skurwa/smart-cart/Final Deliverables/Poster/images/smartCart.JPG

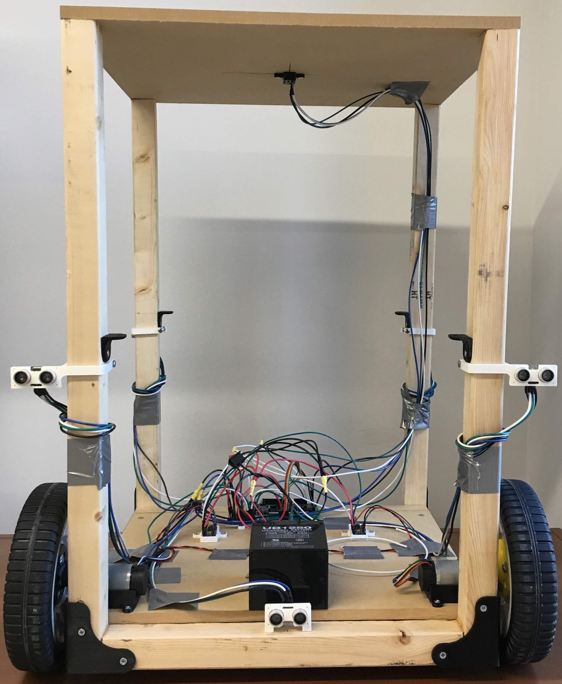
Final Deliverables/Poster/images/smartCart.JPG
