skurwa/smart-cart/README.md

# smart-cart
Design, analysis, schematics, code, and documentation of project to build an autonomous shopping cart.
