skurwa/smart-cart/Proposal/Smart Cart Proposal.docx

Smart Cart Proposal

Siddharth Kurwa

Mechanical Engineering

University of Texas at Austin

16 August 2018

Revision 2

# Background

In the 1930s, a supermarket owner named Sylvan Goldman recognized a critical problem to his business: shoppers only purchased as much as they could carry. To overcome this, Goldman designed and implemented a cart to enable people to carry more products through his stores. While consumers were initially reluctant to use the cart in Goldman’s Humpty Dumpty supermarket chain, the shopping cart now pervades across most stores and is intrinsically tied to our modern shopping experience (Dunne, 2014).

Between 1937 and today, there have been modest updates to the shopping cart to optimize the design and reflect improvements in materials and manufacturing techniques. For example, modern cart cages are largely made of plastic rather than the spot-welded steel, rear walls are hinged to enable efficient stacking and storage, and product storage capacity has increased to 15,000 cubic inches to ensure that volume availability does not limit quantity of purchases (Crockett, 2016). To date, these improvements have been largely focused on mechanical design modifications, unreflective of current technology trends.

Today’s growing sensor solutions, rising storage and data capacities, and increased accessibility of powerful controllers have propelled growth in “intelligent” and connected devices like smart home systems, autonomous vehicles, and health-monitoring wearables (Ahmed, n.d.). These technologies can be applied to the shopping cart to further refine the in-store consumer journey.

To that end, modern retailers are actively working on deploying these technologies to drive consumer retention and growth. For instance, FiveElements Robotics developed a robotic shopping cart called Dash in 2016 to follow users around a store, carry products, and handle the payment process. However, after partnering with Walmart and scheduling production for early 2017, the product has not yet demonstrated the reliability to justify implementation at scale (Ackerman, 2016). Part of the reason is that there are still open areas of research like indoor localization that need refinement before commercialization (Zafari et. al., 2018).

That said, there is tremendous opportunity in working on this technology. The smart cart is a progression of the shopping cart to further address consumer’s latent needs. Consumers should no longer fret about strolling their cart or scanning their groceries, liberating the shopping experience. Beyond the grocery store, the smart cart’s underlying technologies have the potential to affect human-robot interactions in several other environments including warehouses, homes, and hotels.

# Project Statement

I envision a fully fleshed-out smart cart to be a motorized vehicle that offers storage volume, navigates around store obstacles (obstacle avoidance and path planning), follows the user around the store (indoor localization and target tracking), seamlessly scans items placed into the cart, and provides a payment terminal on the cart itself.

For the scope of this course, I plan to build a system with primary emphasis on the design and prototyping of the motorized system, secondary emphasis on obstacle avoidance and navigation control, and tertiary emphasis on indoor localization and target tracking. At this stage, I do not plan to work on the item scanner and payment terminal tasks of the cart. Further, industrial design and aesthetic will not be a priority in this functional prototype.

I propose that the minimum deliverable at the end of this course is a mobile robot that can carry a specified payload and reasonably sense and avoid obstacles in its path. Further the robot should demonstrate design intent and robustness that will allow it to serve as a platform for subsequent research on tasks involving indoor localization, item scanning, and payment handling.

# Schedule

This section will address how the project is being time-budgeted and appropriately scheduled to meet the minimum deliverable by the end of the semester.

Figure 1, below, depicts a high-level Gantt chart that roughly outlines the order in which tasks will be completed. As shown below, several weeks have been allocated towards testing and tuning. I anticipate that there are several issues and considerations that I will uncover as I dive into this project. To manage effectively manage those before the deliverable date, I have allotted several weeks to hashing out the details of the project. Further, five weeks have been allotted for part selection to account for finding parts and lead times to actually procure them.

Figure 1: Gantt chart.

To break down the project into manageable chunks before the deliverable date, I have set several milestones that will ensure that the project is tracking to successful completion. Figure 2 describes these milestones and their intended completion dates.

Figure 2: Milestone chart.

To plan the low-level tasks that must be completed and the hours that I anticipate each task taking, I have assembled a list in Figure 3 with sporty estimates of time requirements. To account for probable aggressiveness in this timeline, I have multiplied my estimates by two to more conservatively estimate time requirements and provide buffer for surprise issues that may arise.

Figure 3: Low-level task list.

# Requirements and Budget

I anticipate requiring a dedicated space in order to store materials and the developing prototype over the course of the semester. Further, I also anticipate requiring funding of $500 which should provide ample margin based on my projected costs that will be explained below. At this point, I have not secured a space or funding – both of which I am actively pursuing.

Given the project is in a preliminary stage, there is no finalized Bill of Materials, but I have listed parts I am fairly certain that I will need in Figure 4 to project a cost ballpark. I anticipate fabricating all the parts using the resources in the Maker Studio or in the student machine shop. I do not plan to require external/expert shop time.

Figure 4: Preliminary Bill of Materials.

# Proposed Credit

The scope of this project will demand that I apply a skillset learned from several courses in my ME degree plan and beyond. From a mechanical standpoint, I expect to use Solidworks for CAD design which uses skills from ME 302, perform some static flexible load analysis which will use EM 319 Mechanics of Solids and ME 338 Machine Elements, and develop some gear reduction or power distribution method that draws from learning in ME 350R Robot Mechanism Design. Motor selection and electronic wiring will use skills from ME 340 Mechatronics and ME 340L. Sensor selection and motor control will involve skills from ME 344 Dynamic Systems and Controls and ME 144L. The obstacle avoidance and indoor localization tasks are largely out of the scope of coursework and will demand that I do some independent learning.

Because of the breadth of this project (design, analysis, prototyping, electronics, and software) and the depth in active research (obstacle avoidance and indoor localization), I believe that it warrants three credit hours as a ME 377K Projects in Mechanical Engineering course.

# Works Cited

Ackerman, E. (2016, June 28). Walmart and Five Elements Robotics Working on Robotic Shopping Cart.

Retrieved August 5, 2018, from https://spectrum.ieee.org/automaton/robotics/industrial-robots/walmart-and-five-elements-robotics-working-on-robotic-shopping-cart

Ahmed, S. (n.d.). The Six Forces Driving the Internet of Things. Retrieved August 5, 2018, from

https://www.pwc.com/gx/en/technology/pdf/six-forces-driving-iot.pdf

Crockett, Z. (2016, February 18). How a Basket on Wheels Revolutionized Grocery Shopping. Retrieved

August 5, 2018, from https://priceonomics.com/how-a-basket-on-wheels-revolutionized-grocery/

Dunne, C. (2014, August 12). Weird History: Inventor Hired Models To Make Shopping Carts Seem Cool.

Retrieved August 5, 2018, from https://www.fastcompany.com/3034248/weird-history-inventor-hired-models-to-make-shopping-carts-seem-cool

Zafari, F., Gkelias, A., & Leung, K. K. (2018). A Survey of Indoor Localization Systems Technologies (Rep.

No. 1709.01015). https://arxiv.org/pdf/1709.01015.pdf
