skurwa/smart-cart/Final Deliverables/Poster/Poster.pptx

Design and Prototype of an Autonomous Shopping Cart

Siddharth Kurwa
Faculty Advisor: Dr. Carolyn Seepersad

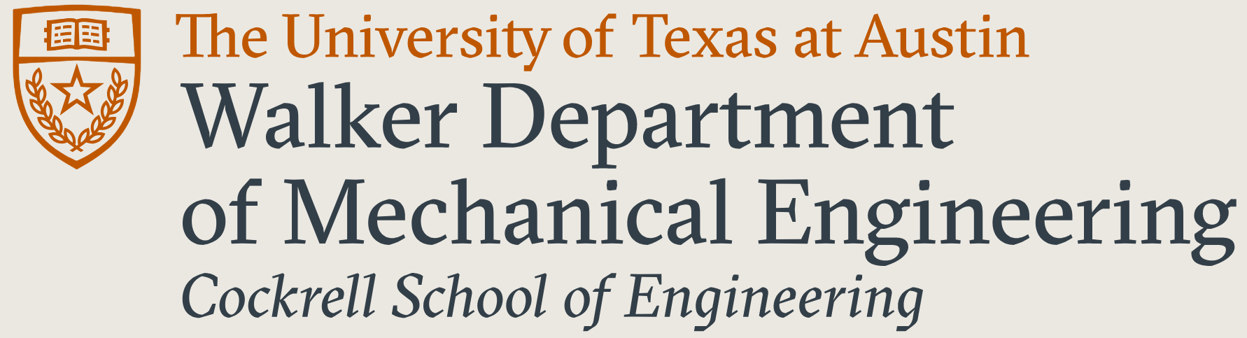
[picture p18: figure]

Background

Control System Design

Proximity Sensor Array

Setpoint Selector

+

PID

Encoder Feedback

Left Motor

Disturbance

+

+

+

PID

Encoder Feedback

Right Motor

Gyro Feedback

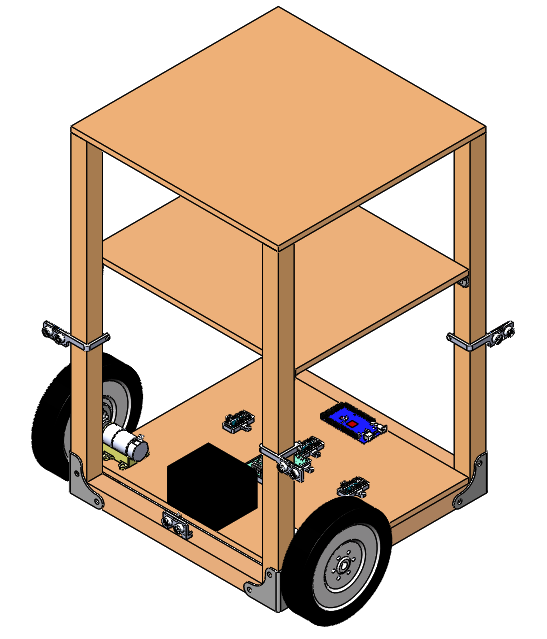
[picture p19: figure]

Distributed Computing Architecture over I²C Network

Proximity Sensor Measurement
Arduino Nano (slave)
4 Hz

Wheel Setpoints

Measured
Velocity

Right Encoder Processing and Motor Drive
Arduino Nano (slave)
10000 Hz

Measured
Velocity

Left Wheel Drive Signal

PID Loop
Arduino Mega (master)
40 Hz

Right Wheel Drive Signal

Left Encoder Processing and Motor Drive
Arduino Nano (slave)
10000 Hz

## Background

## Project Goals

## Mechanical Prototype

## Electrical Prototype

## Slide 6
