skurwa/smart-cart/Proposal/Smart Cart Proposal, rev3.pdf

### Smart Cart Proposal

Siddharth Kurwa
Mechanical Engineering
University of Texas at Austin 16 August 2018
Revision 3

Contents

Background
In the 1930s, a supermarket owner named Sylvan Goldman recognized a critical problem to his business: shoppers only purchased as much as they could carry. To overcome this, Goldman designed and implemented a cart to enable people to carry more products through his stores. While consumers were initially reluctant to use the cart in Goldman’s Humpty Dumpty supermarket chain, the shopping cart now pervades across most stores and is intrinsically tied to our modern shopping experience (Dunne, 2014).
Between 1937 and today, there have been modest updates to the shopping cart to optimize the design and reflect improvements in materials and manufacturing techniques. For example, modern cart cages are largely made of plastic rather than the spot-welded steel, rear walls are hinged to enable efficient stacking and storage, and product storage capacity has increased to 15,000 cubic inches to ensure that volume availability does not limit quantity of purchases (Crockett, 2016). To date, these improvements have been largely focused on mechanical design modifications, unreflective of current technology trends.
Today’s growing sensor solutions, rising storage and data capacities, and increased accessibility of powerful controllers have propelled growth in “intelligent” and connected devices like smart home systems, autonomous vehicles, and health-monitoring wearables (Ahmed, n.d.). These technologies can be applied to the shopping cart to further refine the in-store consumer journey.
To that end, modern retailers are actively working on deploying these technologies to drive consumer retention and growth. For instance, FiveElements Robotics developed a robotic shopping cart called Dash in 2016 to follow users around a store, carry products, and handle the payment process. However, after partnering with Walmart and scheduling production for early 2017, the product has not yet demonstrated the reliability to justify implementation at scale (Ackerman, 2016). Part of the reason is that there are still open areas of research like indoor localization that need refinement before commercialization (Zafari et. al., 2018).
That said, there is tremendous opportunity in working on this technology. The smart cart is a progression of the shopping cart to further address consumer’s latent needs. Consumers should no longer fret about strolling their cart or scanning their groceries, liberating the shopping experience. Beyond the grocery store, the smart cart’s underlying technologies have the potential to affect humanrobot interactions in several other environments including warehouses, homes, and hotels.

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

Schedule
This section will address how the project is being time-budgeted and appropriately scheduled to meet the minimum deliverable by the end of the semester.
Figure 1, below, depicts a high-level Gantt chart that roughly outlines the order in which tasks will be completed. Five weeks have been allotted for part selection to account for finding parts and lead times to actually procure them. As shown below, several weeks have been allocated towards testing and tuning. I anticipate that there are several issues and considerations that I will uncover as I dive into this project. To manage effectively manage those before the deliverable date, I have allotted several weeks to hashing out the details of the project. During this testing/tuning period, I also plan to prepare the poster and final report material required for course completion.

Figure 1: Gantt chart.

To break down the project into manageable chunks before the deliverable date, I have set several milestones that will ensure that the project is tracking to successful completion. Figure 2 describes these milestones and their intended completion dates.

Figure 2: Milestone chart.

To plan the low-level tasks that must be completed and the hours that I anticipate each task taking, I have assembled a list in Figure 3 with sporty estimates of time requirements. To account for probable aggressiveness in this timeline, I have multiplied my estimates by two to more conservatively estimate time requirements and provide buffer for surprise issues that may arise.

1 | 2 | 3 | 4 | 5 | 6 | 7 | 8 | 9 | 10 | 11 | 12 | 13 | 14 | 15
| Mechanical Design | | | | | | | | Week Phase
| Analysis
| Part Selection
| Prototyping
| Testing/Tuning
| Controls

End of:
Week 2 | Concept sketches and low-resolution prototypes developed.
Week 4 | CAD assembly completed. After this point, only tweaks and modifications should be necessary.
Week 6 | Electrical wiring/soldering/connectorizing should be completed.
Week 7 | Basic motor control functions complete and sensors are individually function-checked.
Week 14 | Obstacle avoidance should be logical and demonstrable.
Week 15 | Prototype demonstration/presentation.

Target Milestones

Figure 3: Low-level task list.

High Level | Tasks

Time Allotment
(hrs; no margin)

Time Allotment
(hrs; conservative)

Fall
| | | 2018? | Status
Design storage compartment | 4 | 8 | Y | Not started
Design wheel base | 7 | 14 | Y | Not started
Design sensor mounting | 4 | 8 | Y | Not started
Select/design power transmission
mechanics | 8 | 16 | Y | Not started
Design controls/power systems
enclosure | 8 | 16 | Y | Not started
Analyze payload capacity | 2 | 4 | Y | Not started
Analyze electrical load
requirements | 3 | 6 | Y | Not started
Analyze mechanical power/torque
distribution | 2 | 4 | Y | Not started
Select motors | 1 | 2 | Y | Not started
Select electrical hardware (power
supplies/circuit elements) | 5 | 10 | Y | Not started
Select sensors for obstacle
detection | 1 | 2 | Y | Not started
Select sensors for target tracking | 5 | 10 | | Not started
Build storage compartment
prototype | 5 | 10 | Y | Not started
Build wheel base prototype | 3 | 6 | Y | Not started
Build sensor mounting | 5 | 10 | Y | Not started
Build controls/power systems
enclosure | 5 | 10 | Y | Not started
System integration and assembly | 8 | 16 | Y | Not started
Configure circuit with necessary
elements | 2 | 4 | Y | Not started
Check functionality of each sensor
independently | 8 | 16 | Y | Not started
Program basic motor control | 2 | 4 | Y | Not started
Program obstacle avoidance
decision tree | 16 | 32 | Y | Not started
Program target tracking | 80 | 160 | | Not started
Program simultaneous target
tracking and obstacle avoidance
with interrupt-based state
machine architecture | 80 | 160 | | Not started
Time Required (All Tasks) | 264 | 528
Time Required (Fall 2018 Tasks) | 99 | 198 Controls Mechanical Design Analysis Part Selection Prototyping

Requirements and Budget
I anticipate needing a dedicated space in order to store materials and the developing prototype over the course of the semester.
Given the project is in a preliminary stage, there is no finalized Bill of Materials, but I have listed parts I am fairly certain that I will need in Figure 4 to project a cost ballpark. I anticipate fabricating all the parts using the resources in the Maker Studio or in the student machine shop. I do not plan to require external/expert shop time.

Figure 4: Preliminary Bill of Materials.

Dr. Seepersad has offered space in her lab and funding up to $250 (further funding can be discussed if necessary). Her support should satisfy my requirements to perform this project.

Proposed Credit
The scope of this project will demand that I apply a skillset learned from several courses in my ME degree plan and beyond. From a mechanical standpoint, I expect to use Solidworks for CAD design which uses skills from ME 302, perform some static flexible load analysis which will use EM 319 Mechanics of Solids and ME 338 Machine Elements, and develop some gear reduction or power distribution method that draws from learning in ME 350R Robot Mechanism Design. Motor selection and electronic wiring will use skills from ME 340 Mechatronics and ME 340L. Sensor selection and motor control will involve skills from ME 344 Dynamic Systems and Controls and ME 144L. The obstacle avoidance and indoor localization tasks are largely out of the scope of coursework and will demand that I do some independent learning.
Because of the breadth of this project (design, analysis, prototyping, electronics, and software) and the depth in active research (obstacle avoidance and indoor localization), I believe that it warrants three credit hours as a ME 377K Projects in Mechanical Engineering course.
Part | Unit Price | Quantity | Price | Source | Purpose
Arduino Mega | $ 36.47 | 1 | $ 36.47 | Amazon | Controls
Ultrasonic sensor | $ 1.96 | 5 | $ 9.78 | Amazon | Controls
Plywood/acrylic sheet | $ 50.00 | All | $ 50.00 | Maker Studio | Electronics enclosure; basket
Wheel | $ 15.00 | 2 | $ 30.00 | Amazon | Wheel base
Spherical caster | $ 15.00 | 1 | $ 15.00 | Amazon | Wheel base
Encoder DC motor | $ 25.00 | 2 | $ 50.00 | Amazon | Power distribution; controls
180 degree servomotor | $ 10.00 | 1 | $ 10.00 | Amazon | Controls
Wood studs | $ 50.00 | All | $ 50.00 | Home Depot | Mechanical frame
Wood screws | $ 12.00 | Pack | $ 12.00 | Amazon | Mechanical joining
Metric fasteners (M2.5/M3) | $ 17.00 | Pack | $ 17.00 | Amazon | Electronics mounting
| | Total: | $ 280.25

Works Cited

Ackerman, E. (2016, June 28). Walmart and Five Elements Robotics Working on Robotic Shopping Cart. Retrieved August 5, 2018, from https://spectrum.ieee.org/automaton/robotics/industrialrobots/walmart-and-five-elements-robotics-working-on-robotic-shopping-cart

Ahmed, S. (n.d.). The Six Forces Driving the Internet of Things. Retrieved August 5, 2018, from https://www.pwc.com/gx/en/technology/pdf/six-forces-driving-iot.pdf

Crockett, Z. (2016, February 18). How a Basket on Wheels Revolutionized Grocery Shopping. Retrieved August 5, 2018, from https://priceonomics.com/how-a-basket-on-wheels-revolutionizedgrocery/

Dunne, C. (2014, August 12). Weird History: Inventor Hired Models To Make Shopping Carts Seem Cool. Retrieved August 5, 2018, from https://www.fastcompany.com/3034248/weird-historyinventor-hired-models-to-make-shopping-carts-seem-cool

Zafari, F., Gkelias, A., & Leung, K. K. (2018). A Survey of Indoor Localization Systems Technologies (Rep. No. 1709.01015). https://arxiv.org/pdf/1709.01015.pdf
