skurwa/smart-cart/Final Deliverables/Poster/Smart Cart Poster.pdf

# Design and Prototype of an Autonomous Shopping Cart

# Siddharth Kurwa, Cockrell School of Engineering, siddharth.kurwa@gmail.com, Fall 2018

Background | Control System Architecture | Obstacle Avoidance Logic

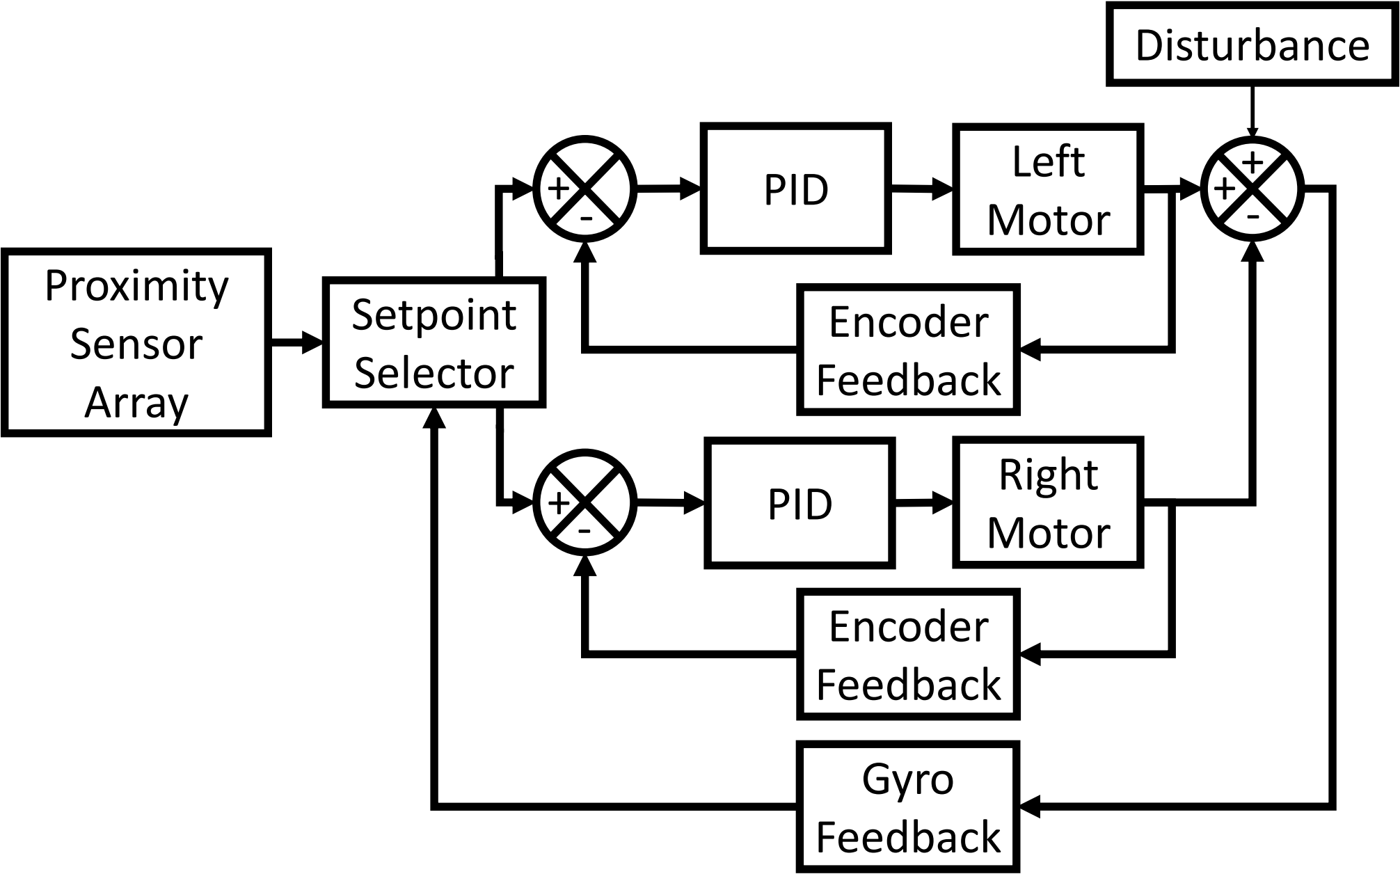
[picture p31: figure]
Left Motor; Encoder Feedback; PID; Right Motor; Gyro Feedback; Proximity Sensor Array; Disturbance; Setpoint Selector
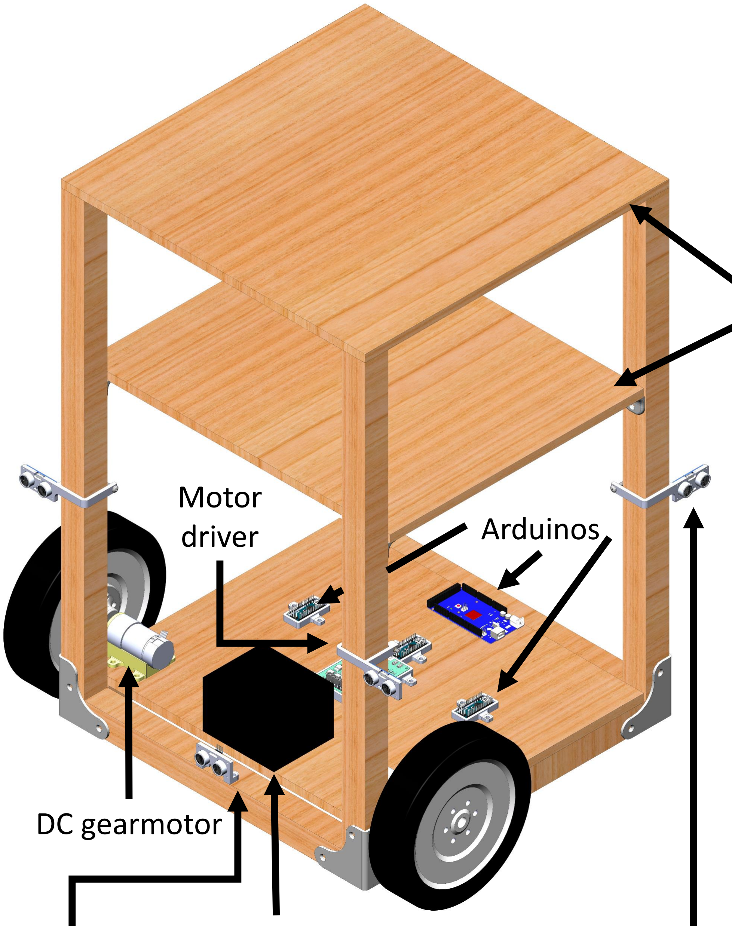
[picture p32: figure]
DC gearmotor; Arduinos; Motor driver
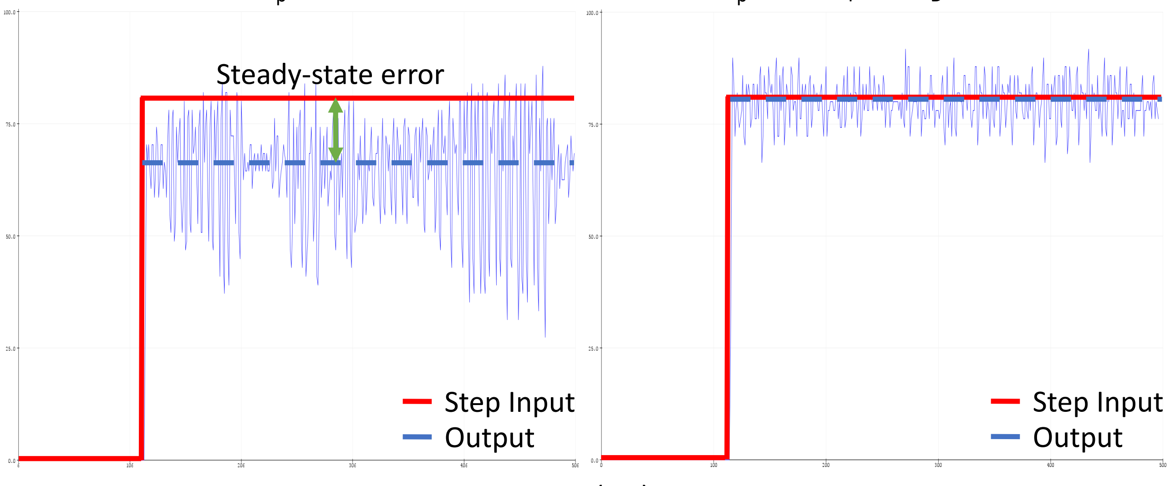
[picture p33: figure]
Step Input Output; Steady-state error
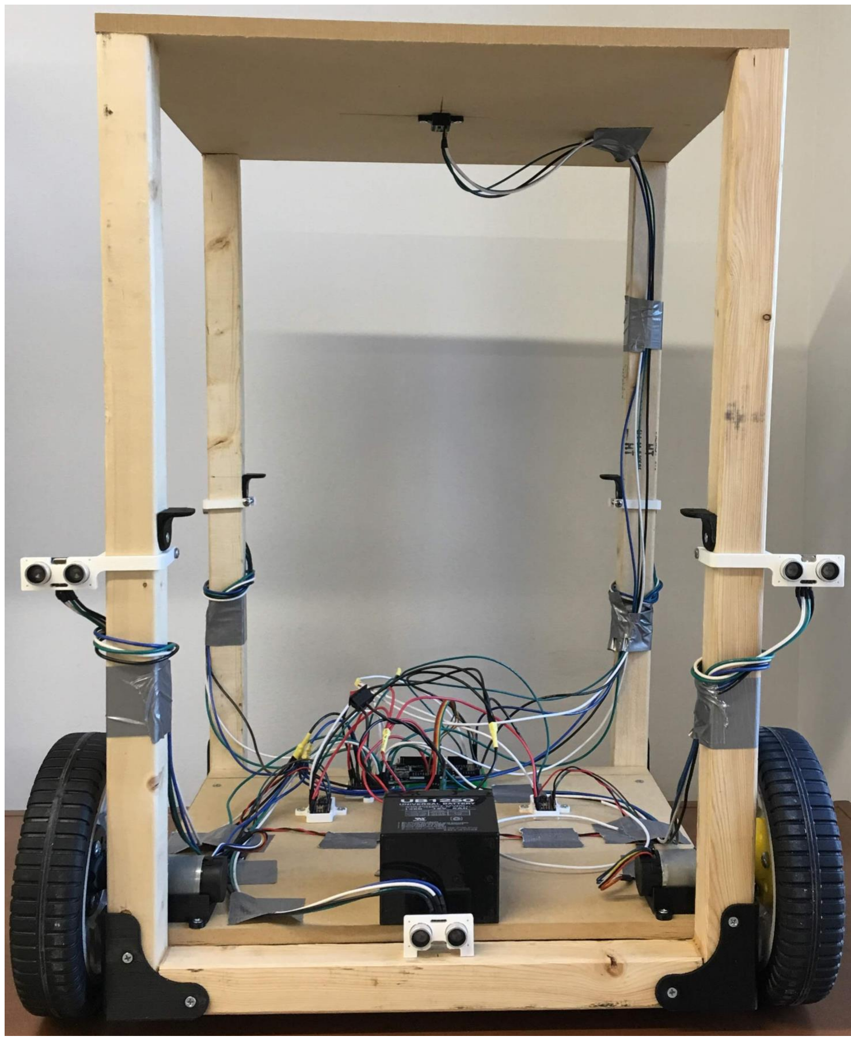
[picture p34: figure]

## Distributed Computing over I

## 2C Network

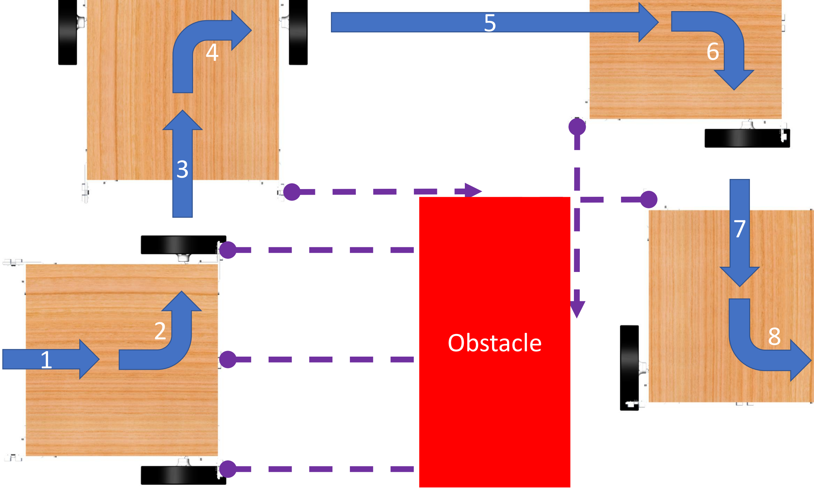
[picture p35: figure]
Obstacle

## Project Goals

## Mechanical Design

## Further Information

CAD, source code, BOM, documentation: | https://github.com/skurwa/smart-cart
To learn more about Sid: | https://skurwa.github.io

## Acknowledgements

I deeply appreciate Dr. Carolyn Seepersad’s support through the semester. Her advice and feedback were instrumental in executing this project.

## Conclusions and Future Work

9

PID controller,
Arduino Mega (master),
Polling at 20 Hz

Right wheel velocity
measurement and motor drive, Arduino Nano (slave),
Event-driven up to 6000 Hz

Left wheel velocity
measurement and motor drive, Arduino Nano (slave),
Event-driven up to 6000 Hz

Proximity sensor measurement and setpoint determination, Arduino Nano (slave),
Polling at 4 Hz

Wheel velocity
setpoints

Measured
velocity
Right wheel
drive signal

Measured
velocity
Left wheel
drive signal
1. Cart approaches obstacle and forward proximity sensors detect obstacle.
2. Cart performs a 90° turn using gyro feedback.
3. Cart moves forward until rear right proximity sensor crosses obstacle.
4. Cart performs a -90° turn using gyro feedback.
5. Cart moves forward until rear right proximity sensor crosses obstacle.
6. Cart performs -90° turn using gyro feedback.
7. Cart moves forward until rear right proximity sensor detects obstacle.
8. Cart performs a 90° turn using gyro feedback.
9. Cart resumes initial path.

The wheel base was modeled on a differential drive robot with one driven caster and two driving wheels. The controllers, power storage, and drive units are all stored on the bottom platform to maximize usable grocery storage volume. This functional prototype has a wooden construction with 3D-printed brackets, fixtures, mounting adapters, and wheel hubs.

Sealed lead acid battery
Ultrasonic proximity sensors

Grocery
storage

At a normal walking speed, each encoder clicks at a 3500 Hz frequency. Further, each proximity sensor requires a minimum 50 ms delay as its operation is limited by the speed of sound. If these tasks were handled serially by a single controller, the PID loop rate would be extremely limited and create significant signal transport delay. To improve dynamic system stability bandwidth by minimizing transport delay, computational tasks were distributed over 4 Arduino microcontrollers and communicated over I

2C protocol. By managing tasks in parallel, the control system was able to achieve a 20 Hz PID loop rate.

Closed-loop speed control is achieved with encoder feedback of each motor. A gyroscope provides closed-loop heading control.

The semester’s project goals have been achieved as the functional prototype performs obstacle avoidance, carries groceries, and offers sufficient onboard processing power to enable testing and implementation of new features.

Improvements to make to the existing system:
- Add a bearing block on the motor shaft to reduce shaft bending and shear loads.
- Mount ultrasonic sensors on a continuous servomotor to provide 360° proximity detection, eliminating current blind-spots.
- Develop smoother path-planning around obstacles rather than solely 90° turns.

New features to incorporate:
- Indoor localization sensing using off-the-shelf options like PixyCam, Bluetooth transmitters/receivers, and Wi-Fi.
- RFID sensors and onboard payment terminals.

## References

Zafari, F., Gkelias, A., & Leung, K. K. (2018). A Survey of Indoor Localization Systems Technologies (Rep. No. 1709.01015). https://arxiv.org/pdf/1709.01015.pdf

To tune the motor PID controllers, the Ziegler-Nichols tuning method was applied. This method is procedure to experimentally estimate optimal PID parameters (KP

, KI

, and KD

) using a proportional
controller to minimize response time, eliminate steady-state error, and maintain system stability.

This project’s goal was to build a functional prototype of a motorized cart with storage volume and the capacity to avoid and navigate around obstacles. This system will serve as a platform to develop, prototype, and test features towards a fully-fleshed autonomous shopping cart.

Fully implemented, an autonomous shopping cart will consist of the following features:
- Offers storage volume comparable to standard shopping carts
- Motion plans around obstacles
- Follows shopper around store
- Automatically scans items placed into the cart
- Provides a payment terminal for shopping

Since the invention of the first shopping cart in 1937, there have only been modest updates to the device design driven by innovation in materials and manufacturing processes. With modern advances in sensing and mechatronics, the shopping cart is prime for a redesign that leverages these technologies.

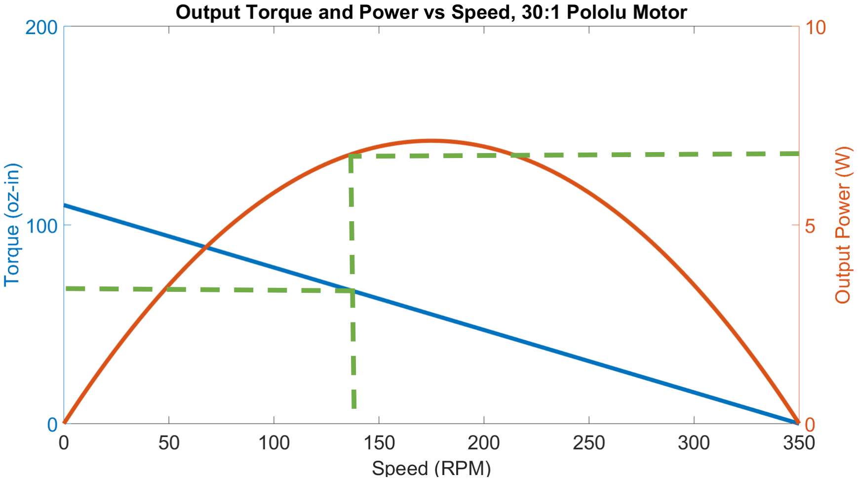
[picture p36: figure]

Based on torque-speed analysis, the DC gearmotor was appropriately sized to handle max torque loads from a 25 lb cart load, human walking speed (5 ft/s), 1 ft/s² acceleration, 0.25° incline, and 70% efficiency.

Proportional Controller
(Kp = 4)

PID Controller
(Kp = 2.4, KI = 6, KD = 0.006)

Wheel Velocity (RPM)

Time (ms)
