skurwa/smart-cart/Analysis/Mechanical Analysis.xlsx

INPUTS |  |  | OUTPUTS
Desired System Parameters |  |  | Desired Performance Characteristics
25.00 | lbf | System weight | 6.67 | W | Wheel output power
4.00 | in | Wheel radius | 9.53 | W | Motor output power
3.00 |  | Support count | 31.76 | W | Motor input power
0.40 |  | Static friction coefficient | 13.33 | lbf-in | Max wheel torque before slip
5.00 | ft/s | Desired cart linear velocity | 3.94 | lbf-in | Wheel torque
1.00 | ft/s^2 | Desired acceleration | 62.97 | oz-in
0.25 | degrees | Climb angle | 15.00 | rad/s | Wheel angular velocity
12.00 | V | Motor voltage | 143.24 | RPM
Off-the-Shelf Gear Characteristics |  |  | Target Motor Characteristics
0.70 |  | Gear efficiency | 1.18 |  | Gear ratio
1.00 | in | Input gear radius | 76.23 | oz-in | Required motor torque
1.18 | in | Output gear radius | 169.02 | RPM | Target angular velocity
 |  |  | 9.53 | W | Target motor output power | 2148.88 | clicks/second
Motor Characteristics |  |  | System Performance, Off-the-Shelf Motor
0.30 |  | Motor efficiency | 76.23 | oz-in | Motor output torque
2.00 |  | Motor count | 107.44 | RPM | Motor output speed
 |  |  | 0.75 |  | Motor-driven gear ratio
 |  |  | 6.06 | W | Off-the-shelf motor output power
 |  |  | 62.97 | oz-in | Off-the-shelf wheel torque
 |  |  | 91.05 | RPM | Off-the-shelf wheel angular velocity
 |  |  | 3.18 | ft/s | Cart linear velocity
 |  |  | 1.68 | A | Motor supply current
Gear Tooth Stress Analysis, Additional Parameters |  |  | Gear Tooth Stress Analysis Results
4.76 | lbf | Tangential force, F_t | 0.57 | ksi | Input gear tooth stress
48.00 |  | Pitch, P | 26.24 |  | Input gear tooth safety factor
0.12 | in | Input width, b | 0.36 | ksi | Output gear tooth stress
0.20 |  | Input Lewis form factor, Y | 41.98 |  | Output gear tooth safety factor
15.00 | ksi | Input yield strength
0.12 | in | Output width, b
0.32 |  | Output Lewis form factor, Y
15.00 | ksi | Output yield strength
Driveshaft Bending Analysis, Additional Parameters |  |  | Driveshaft Bending Stress Analysis Results
0.38 | in | Diameter | 8.05 | ksi | Shaft bending stress
5.00 | in | Cantilevered length | 4.97 |  | Shaft bending safety factor
40.00 | ksi | Yield strength
