skurwa/smart-cart/Final Deliverables/Poster/images/front view_cart.png

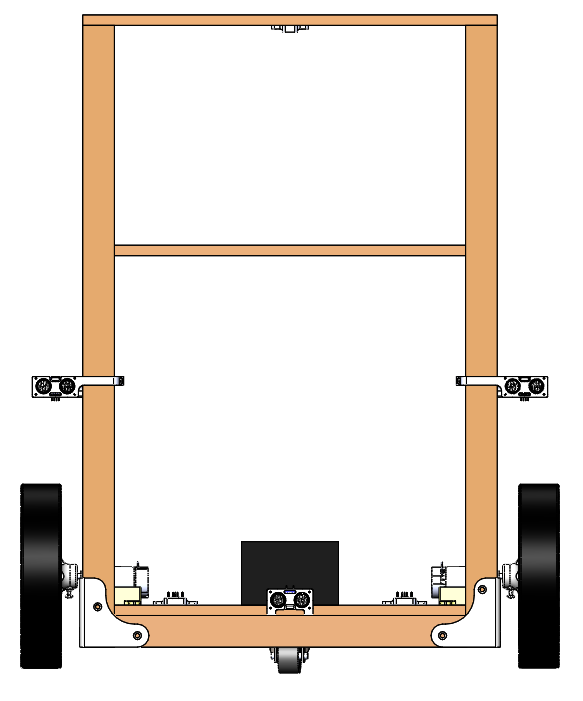
Final Deliverables/Poster/images/front view_cart.png
