skurwa/smart-cart/Final Deliverables/Poster/images/k_p2.4 k_i4 k_d.05.PNG

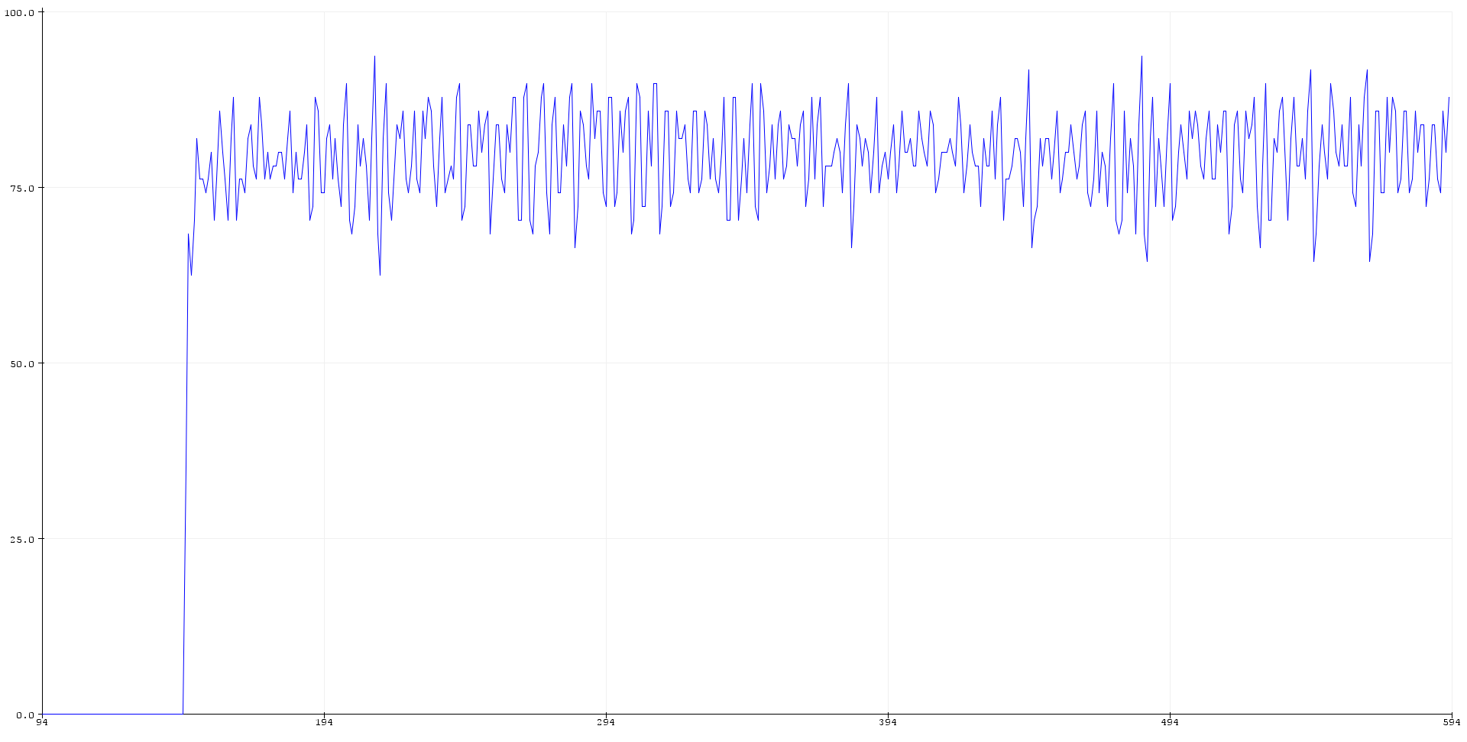
Final Deliverables/Poster/images/k_p2.4 k_i4 k_d.05.PNG
