skurwa/smart-cart/Final Deliverables/Poster/images/k_p2.4 k_i6 k_d_0.006.PNG

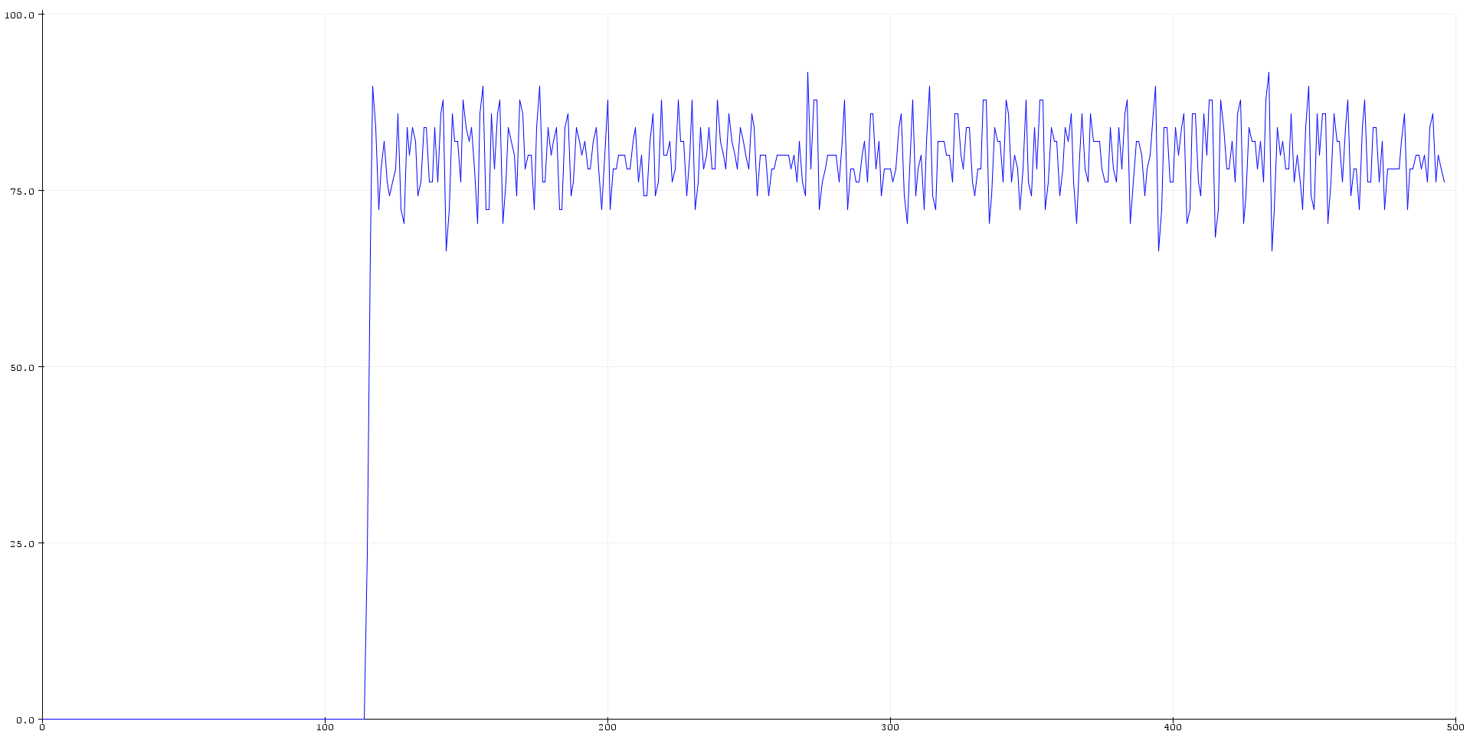
Final Deliverables/Poster/images/k_p2.4 k_i6 k_d_0.006.PNG
