skurwa/smart-cart/Final Deliverables/Poster/images/k_p4.PNG

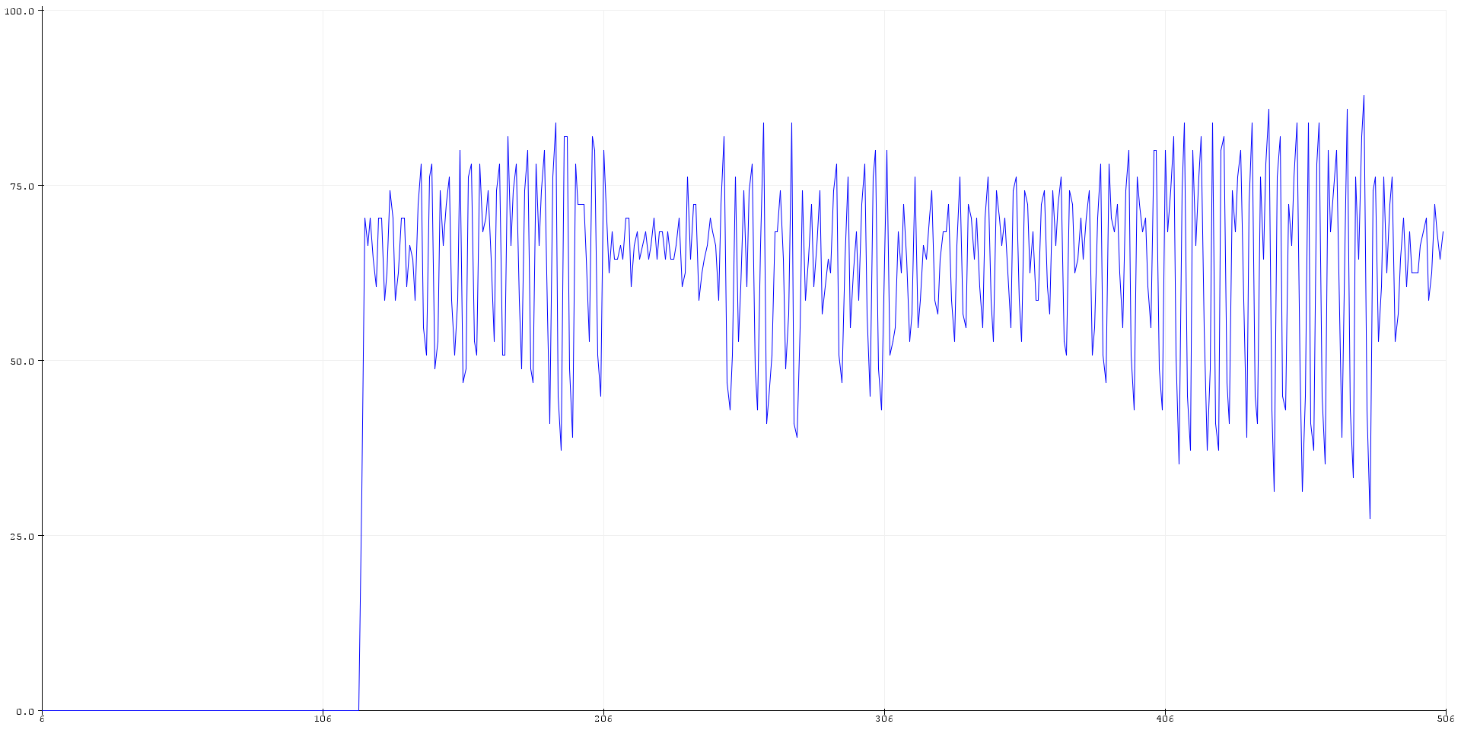
Final Deliverables/Poster/images/k_p4.PNG
