skurwa/smart-cart/Final Deliverables/Poster/images/section view_ultrasonic sensor fixture.png

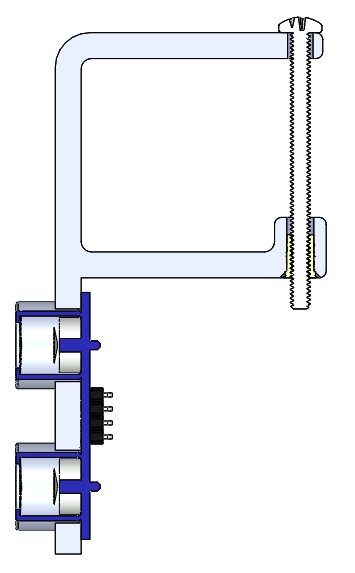
Final Deliverables/Poster/images/section view_ultrasonic sensor fixture.png
