skurwa/smart-cart/Final Deliverables/Poster/images/section view_wheel drive.png

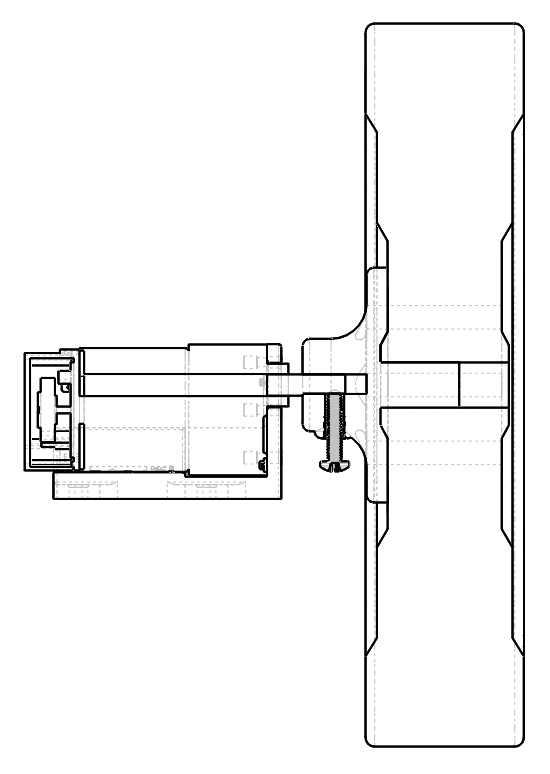
Final Deliverables/Poster/images/section view_wheel drive.png
