skurwa/smart-cart/Final Deliverables/Poster/images/top view_cart.png

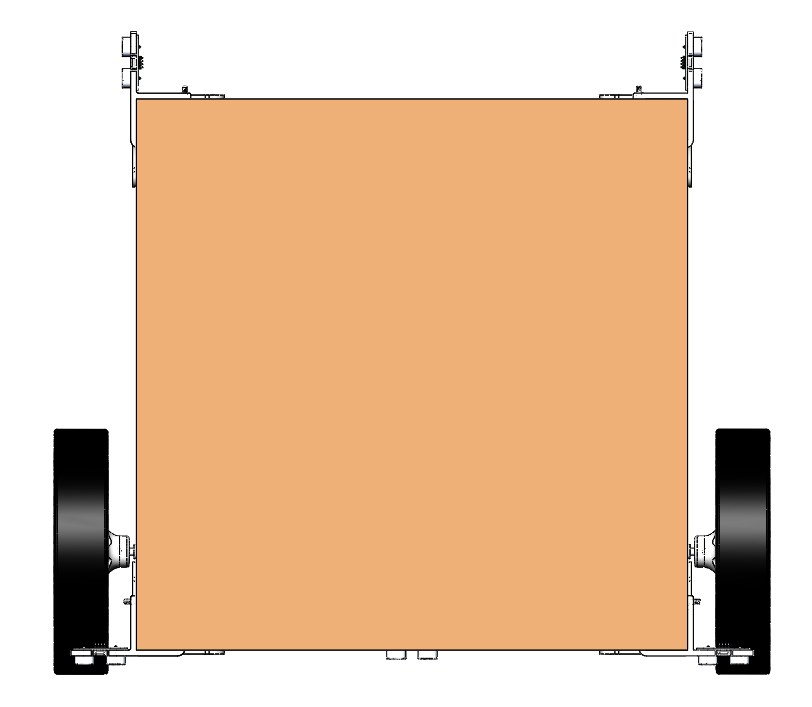
Final Deliverables/Poster/images/top view_cart.png
