skurwa/smart-cart/Final Deliverables/Poster/images/torqueSpeedMotorCurve.png

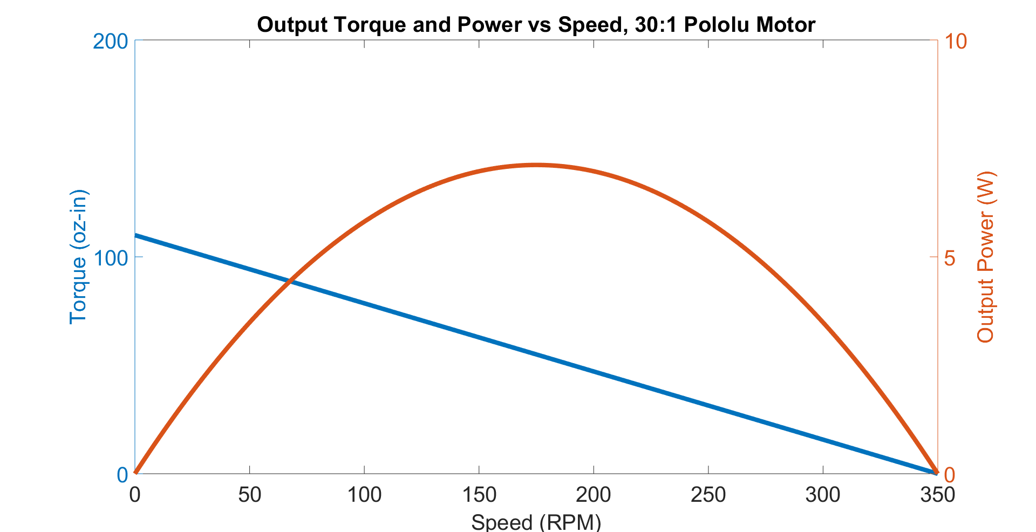
Final Deliverables/Poster/images/torqueSpeedMotorCurve.png
