skurwa/smart-cart/BOM.xlsx

Part | Source | Unit Price | Qty | Specifications | Unit Weight (lbs) | Total Weight (lbs) | Ordered? | Received? | System Cost | Off-the-Shelf System Weight (lbs)
micro servo (https://www.amazon.com/dp/B071KJV7DD/?coliid=I2ZFOMHSP477D7&colid=LOHER8WQ5TYZ) | Amazon | $3.94 | 2.00 |  | 0.02 | 0.04 | y | y | $235.24 | 28.84
SLA battery (https://www.amazon.com/dp/B001DL9IBC/ref=cm_sw_r_cp_api_WNW6BbDREW192) | Amazon | $14.99 | 1.00 | 6V, 12Ah | 3.70 | 3.70 | y | y
SLA battery charger (https://www.amazon.com/dp/B001G8AIMU/?coliid=I2XQFYEHO7685J&colid=LOHER8WQ5TYZ) | Amazon | $9.70 | 1.00 |  | 0.05 | 0.05 | y | y
Arduino Nano (https://www.amazon.com/dp/B0713XK923/?coliid=I37YT5FHJHX46W&colid=LOHER8WQ5TYZ) | Amazon | $4.62 | 3.00 |  | 0.01 | 0.04 | y | y
Arduino Mega (https://www.amazon.com/dp/B01H4ZDYCE/?coliid=I2B1Q3D2Q69V0S&colid=LOHER8WQ5TYZ) | Amazon | $14.86 | 1.00 |  | 0.08 | 0.08 | y | y
motor driver (https://www.amazon.com/dp/B01M5I2NFM/?coliid=I3UC4KB46M3V23&colid=LOHER8WQ5TYZ) | Amazon | $28.80 | 1.00 | 10A Dual-channel; 5-25V; 30 A peak | 0.07 | 0.07 | y | y
ultrasonic sensor (https://www.amazon.com/dp/B01COSN7O6/?coliid=I29LQF48OTFS5H&colid=LOHER8WQ5TYZ) | Amazon | $1.96 | 5.00 | HC-SR04 | 0.0025 | 0.01 | y | y
12V gearmotor (https://www.pololu.com/product/2823) | Pololu | $39.95 | 2.00 |  | 0.47 | 0.95 | y | y
3D Compass (https://www.pololu.com/product/2127) | Pololu | $7.95 | 1.00 | LSM303D | 0.00132277 | 0.00132277 | y | y
basketPlatform (https://www.homedepot.com/p/1-2-in-2-ft-x-2-ft-Medium-Density-Fiber-Board-1508107/205881911) | Home Depot | $5.53 | 1.00 | 2'x2'-0.451" plywood | 5.68 | 5.68 | y | y
drivePlatform (https://www.homedepot.com/p/1-2-in-2-ft-x-2-ft-Medium-Density-Fiber-Board-1508107/205881911) | Home Depot | $5.53 | 1.00 | 2'x2'-0.451" plywood | 5.68 | 5.68 | y | y
column (https://www.homedepot.com/p/2-in-x-2-in-x-8-ft-Furring-Strip-Board-165360/202076422) | Home Depot | $2.15 | 2.00 | 1.375"x1.37"-96" strip board | 4.00 | 8.00 | y | y
heat set inserts | Self-supplied | $0.00 | 6.00 | 8-32 screw size (L) | 0.01 | 0.03 | n | y
caster wheel (https://www.homedepot.com/p/Everbilt-1-1-2-in-Soft-Rubber-Swivel-Plate-Caster-with-40-lb-Load-Rating-49489/203661072) | Home Depot | $2.97 | 1.00 | 40 lb load rating | 0.41 | 0.41 | y | y
drive wheel (https://www.homedepot.com/p/Arnold-8-in-Universal-Plastic-Wheel-with-Adapters-490-322-0011/304591962) | Home Depot | $8.14 | 2.00 |  | 2.00 | 4.00 | y | y
fuses (https://www.amazon.com/dp/B07786GPGK/?coliid=I26GW8KZ0WVEKG&colid=LOHER8WQ5TYZ) | Amazon | $12.90 | 1.00 | 220 pieces | 0.10 | 0.10 | y | y
