skurwa/smart-cart/Proposal/Smart Cart - Task List.xlsx

Sheet: Task List
High Level | Tasks | Time Allotment (hrs; no margin) | Time Allotment (hrs; conservative) | Fall 2018? | Status | Assumptions
Mechanical Design | Design storage compartment | 4 | 8 | Y | Not started | Time Uncertainty Multiplier | 2
 | Design wheel base | 7 | 14 | Y | Not started | Weekly Time Allotment (hrs) | 10
 | Design sensor mounting | 4 | 8 | Y | Not started
 | Select/design power transmission mechanics | 8 | 16 | Y | Not started |  | Weeks to Completion
 | Design controls/power systems enclosure | 8 | 16 | Y | Not started | No margin; all tasks | 26.4
Analysis | Analyze payload capacity | 2 | 4 | Y | Not started | Conservative; all tasks | 52.8
 | Analyze electrical load requirements | 3 | 6 | Y | Not started | No margin; select tasks | 9.9
 | Analyze mechanical power/torque distribution | 2 | 4 | Y | Not started | Conservative; select tasks | 19.8
Part Selection | Select motors | 1 | 2 | Y | Not started
 | Select electrical hardware (power supplies/circuit elements) | 5 | 10 | Y | Not started
 | Select sensors for obstacle detection | 1 | 2 | Y | Not started
 | Select sensors for target tracking | 5 | 10 |  | Not started
Prototyping | Build storage compartment prototype | 5 | 10 | Y | Not started
 | Build wheel base prototype | 3 | 6 | Y | Not started
 | Build sensor mounting | 5 | 10 | Y | Not started
 | Build controls/power systems enclosure | 5 | 10 | Y | Not started
 | System integration and assembly | 8 | 16 | Y | Not started
Controls | Configure circuit with necessary elements | 2 | 4 | Y | Not started
 | Check functionality of each sensor independently | 8 | 16 | Y | Not started
 | Program basic motor control | 2 | 4 | Y | Not started
 | Program obstacle avoidance decision tree | 16 | 32 | Y | Not started
 | Program target tracking | 80 | 160 |  | Not started
 | Program simultaneous target tracking and obstacle avoidance with interrupt-based state machine architecture | 80 | 160 |  | Not started
 | Time Required (All Tasks) | 264 | 528
 | Time Required (Fall 2018 Tasks) | 99 | 198
 |  |  |  |  |  |  |  | 16

Sheet: Gantt Chart
 |  | Week
 |  | 1 | 2 | 3 | 4 | 5 | 6 | 7 | 8 | 9 | 10 | 11 | 12 | 13 | 14 | 15
Phase | Mechanical Design
 | Analysis
 | Part Selection
 | Prototyping
 | Testing/Tuning
 | Controls
 |  | Target Milestones
 |  | End of:
 |  | Week 4 | CAD assembly completed. After this point, only tweaks and modifications should be necessary.
 |  | Week 6 | Electrical wiring/soldering/connectorizing should be complete.
 |  | Week 7 | Basic motor control functions should be complete and sensors should be individually function-checked.
 |  | Week 14 | Obstacle avoidance should be demonstrable and logical.
 |  | Week 15 | Prototype demonstration/presentation.

Sheet: BOM
Part | Unit Price | Quantity | Price | Source | Purpose
Arduino Mega | $36.47 | 1 | $36.47 | Amazon | Controls
Ultrasonic sensor | $1.96 | 5 | $9.78 | Amazon | Controls
Plywood/acrylic sheet | $50.00 | All | $50.00 | Maker Studio | Electronics enclosure; basket
Wheel | $15.00 | 2 | $30.00 | Amazon | Wheel base
Spherical caster | $15.00 | 1 | $15.00 | Amazon | Wheel base
Encoder DC motor | $25.00 | 2 | $50.00 | Amazon | Power distribution; controls
180 degree servomotor | $10.00 | 1 | $10.00 | Amazon | Controls
Wood studs | $50.00 | All | $50.00 | Home Depot | Mechanical frame
Wood screws | $12.00 | Pack | $12.00 | Amazon | Mechanical joining
Metric fasteners (M2.5/M3) | $17.00 | Pack | $17.00 | Amazon | Electronics mounting
 |  | Total: | $280.25
