skurwa/smart-cart/CAD/assem_wheelDrive.SLDASM

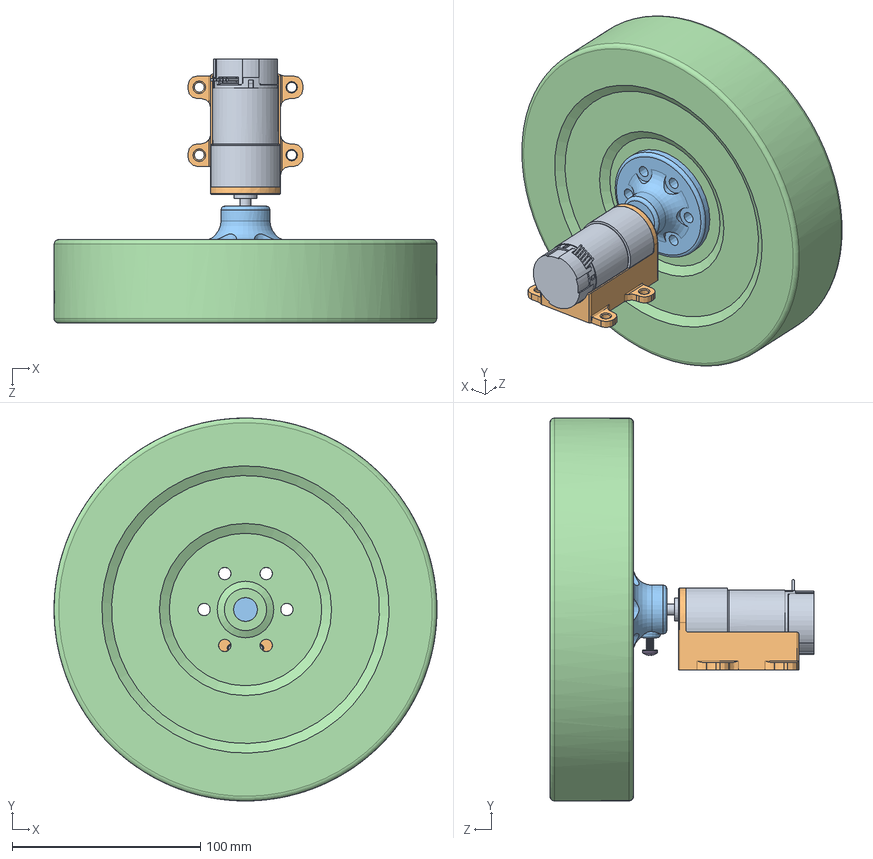
[picture p45: CAD file, 2018-11-27]
CAD/assem_wheelDrive.SLDASM
203.2 x 203.2 x 140.3 mm
gearmotor_Pololu_30-1
motorMount
hub_v2
wheel
93365A142_HEAT-SET INSERTS FOR PLASTICS
91772A197_18-8 SS PAN HEAD PHILLIPS MACHINE SCREW
