skurwa/smart-cart/CAD/assem_frame.SLDASM

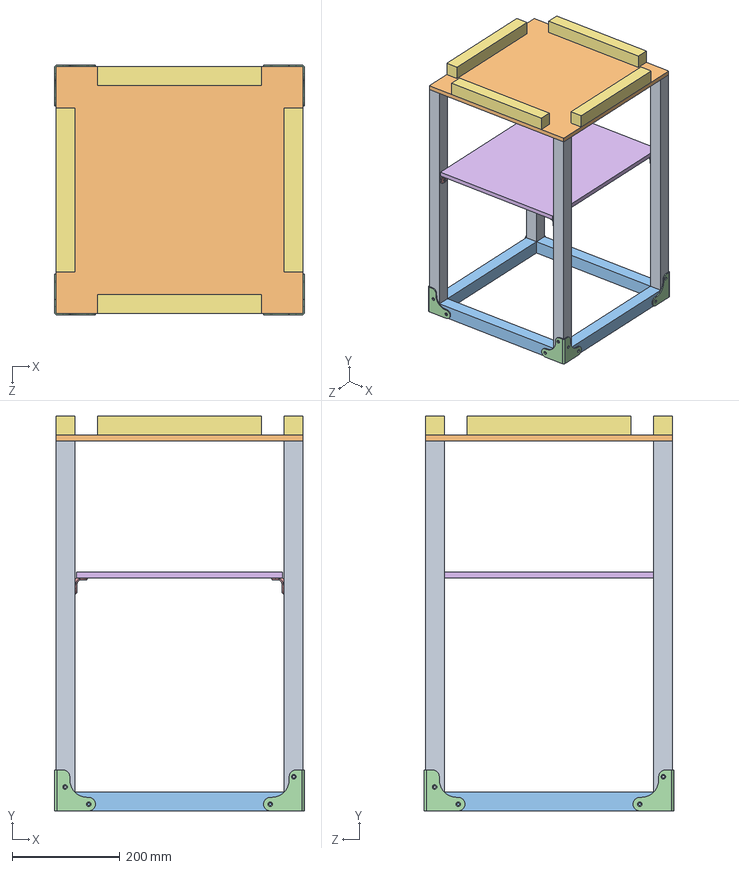
[picture p46: CAD file, 2018-11-27]
CAD/assem_frame.SLDASM
463.5 x 732.2 x 463.5 mm
column x 4
basketPlatform
side x 4
frameBracket x 4
lowerPlatformSupport x 4
lowerBasketPlatform
basketSiding x 4
