skurwa/smart-cart/CAD/assem_leftMountedUSSensor.SLDASM

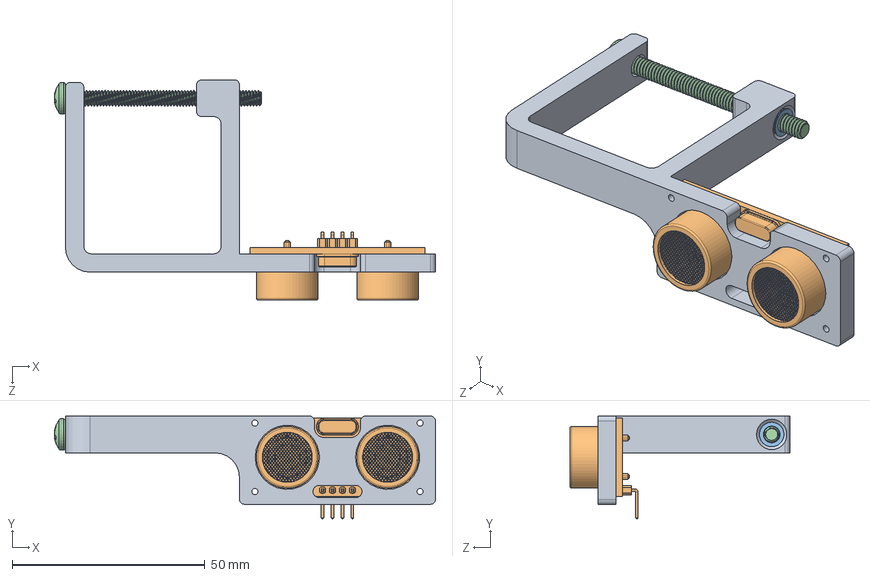
[picture p47: CAD file, 2018-11-12]
CAD/assem_leftMountedUSSensor.SLDASM
98.7 x 26.6 x 57.1 mm
ultrasonicSensorLeftMount
ultrasonicSensor_hc-sr04
93365A142_HEAT-SET INSERTS FOR PLASTICS
91772A205_18-8 SS PAN HEAD PHILLIPS MACHINE SCREW
