skurwa/smart-cart/CAD/Purchased Parts/assem_rightMountedUSSensor.SLDASM

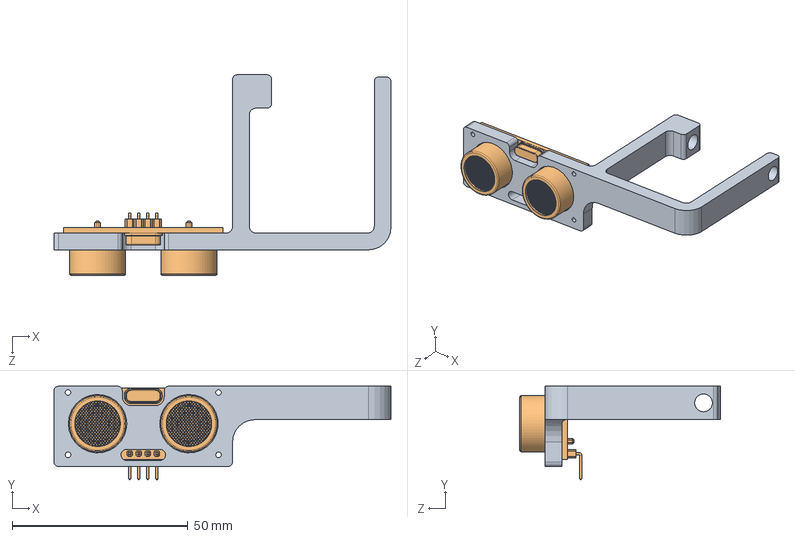
[picture p48: CAD file, 2018-11-08]
CAD/Purchased Parts/assem_rightMountedUSSensor.SLDASM
95.9 x 26.6 x 57.1 mm
ultrasonicSensorRightMount
ultrasonicSensor_hc-sr04
