skurwa/smart-cart/CAD/assem_caster.SLDASM

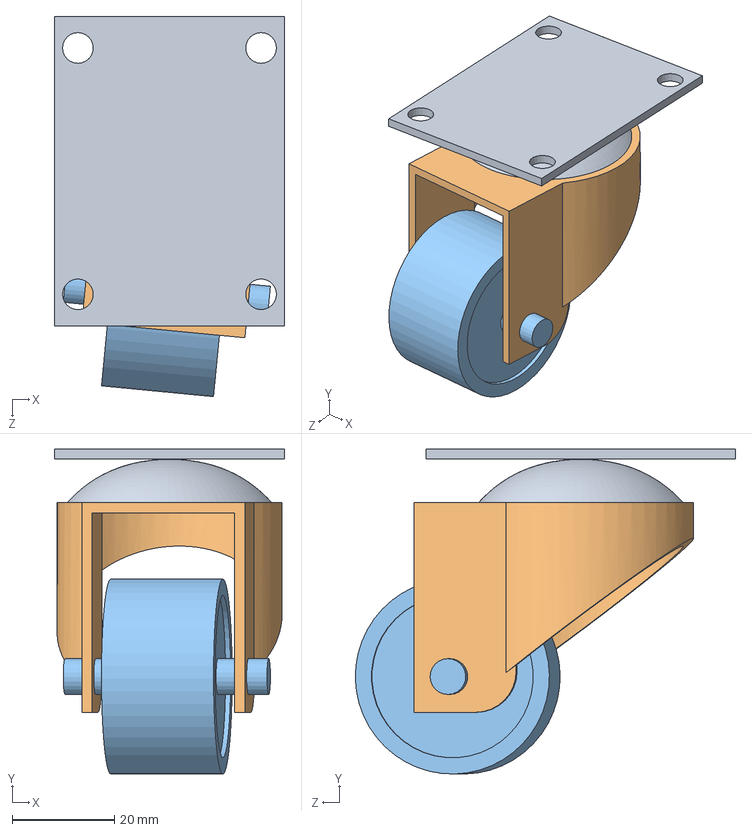
[picture p49: CAD file, 2018-11-11]
CAD/assem_caster.SLDASM
45.0 x 63.5 x 74.3 mm
casterMountingPlate
casterSwivel
casterWheel
