skurwa/smart-cart/CAD/assem_mountedArduinoNano.SLDASM

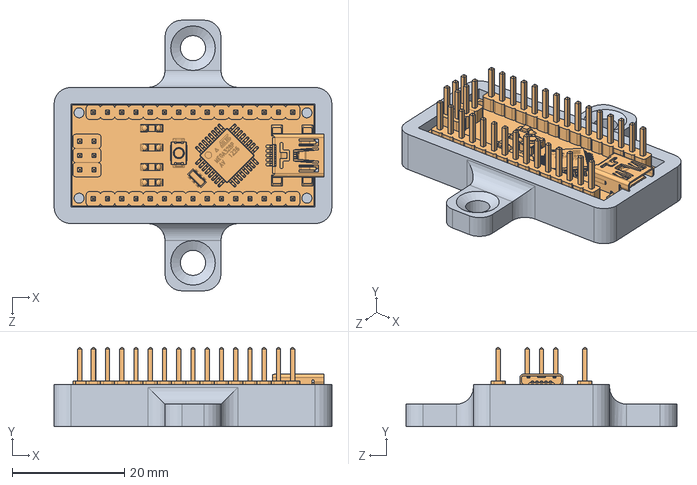
[picture p50: CAD file, 2018-11-11]
CAD/assem_mountedArduinoNano.SLDASM
49.6 x 14.1 x 48.3 mm
arduinoNanoMount
arduinoNano_Elegoo
