skurwa/smart-cart/CAD/assem_mountedCompassIC.SLDASM

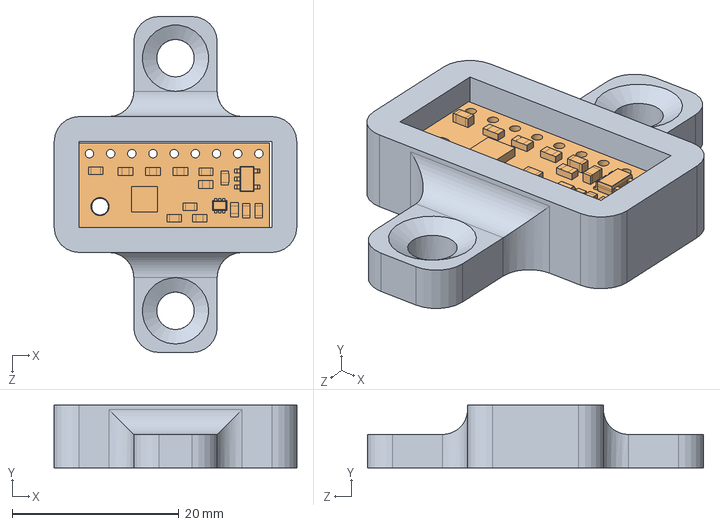
[picture p51: CAD file, 2018-11-11]
CAD/assem_mountedCompassIC.SLDASM
29.1 x 7.50 x 40.3 mm
compassMount
compassIC_LSM303D
