skurwa/smart-cart/CAD/assem_centerMountedUSSensor.SLDASM

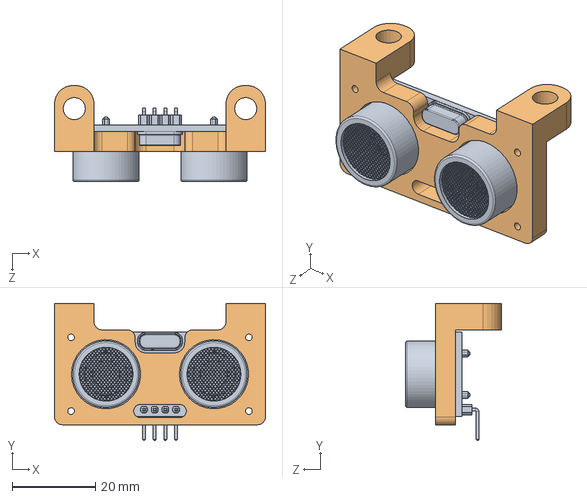
[picture p52: CAD file, 2018-11-11]
CAD/assem_centerMountedUSSensor.SLDASM
50.8 x 33.0 x 23.1 mm
ultrasonicSensor_hc-sr04
ultrasonicSensorCenterMount
