skurwa/smart-cart/CAD/assem_drive.SLDASM

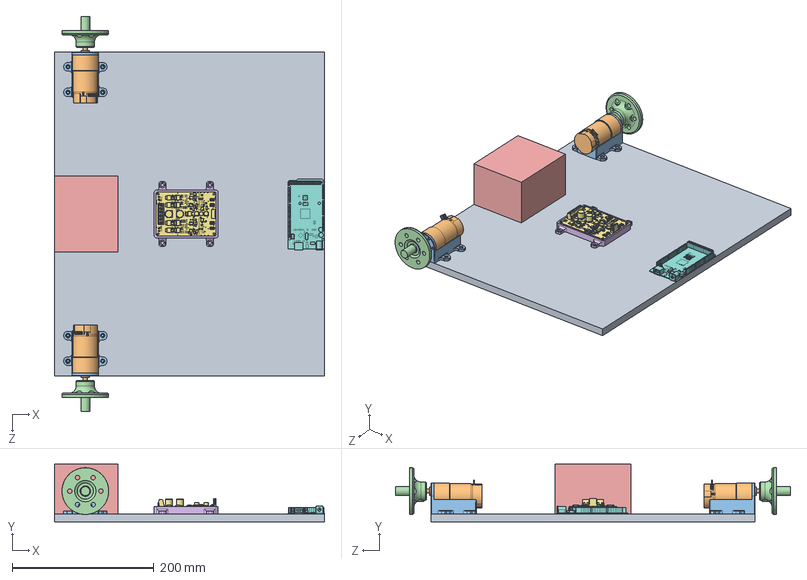
[picture p53: CAD file, 2018-11-08]
CAD/assem_drive.SLDASM
381.0 x 81.6 x 557.2 mm
drivePlatform
gearmotor_Pololu_30-1 x 2
motorMount x 2
hub_v2 x 2
slaBattery_ExpertPower
motorDriverMount
motorController_Cytron
arduinoMega_Elegoo
