skurwa/smart-cart/CAD/assem_cart.SLDASM

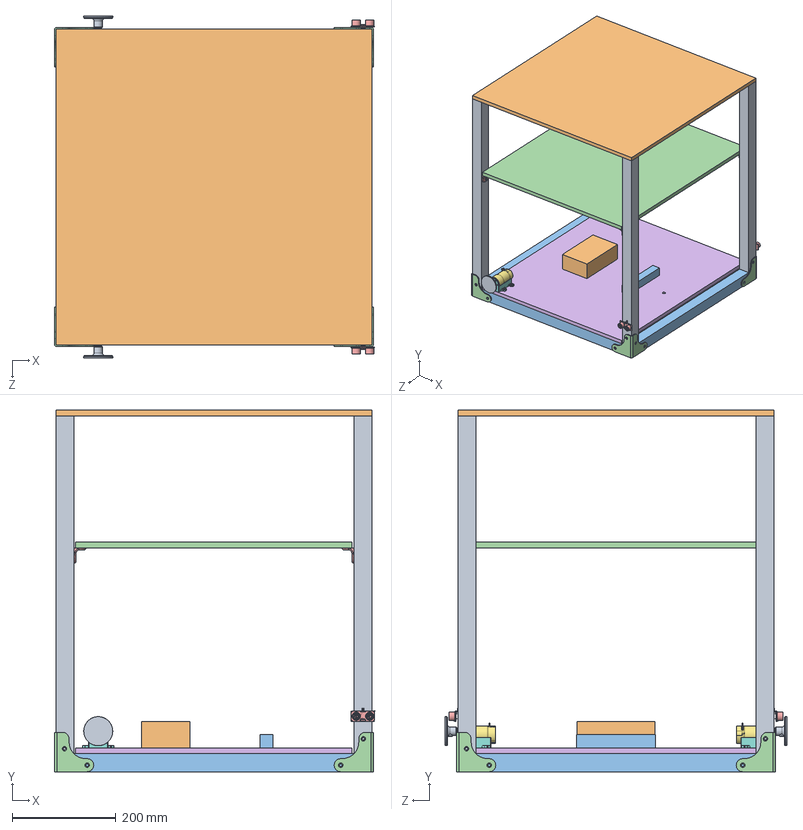
[picture p54: CAD file, 2018-09-25]
CAD/assem_cart.SLDASM
618.1 x 697.3 x 659.6 mm
column x 4
basketPlatform
side x 4
frameBracket x 4
controlsPlatformSupport x 4
drivePlatform
gearmotor_Pololu_30-1 x 2
motorMount x 2
hub x 2
slaBattery_ExpertPower
groundBlock
controlsPlatform
ultrasonicSensor_hc-sr04 x 2
