skurwa/smart-cart/CAD/assem_controls.SLDASM

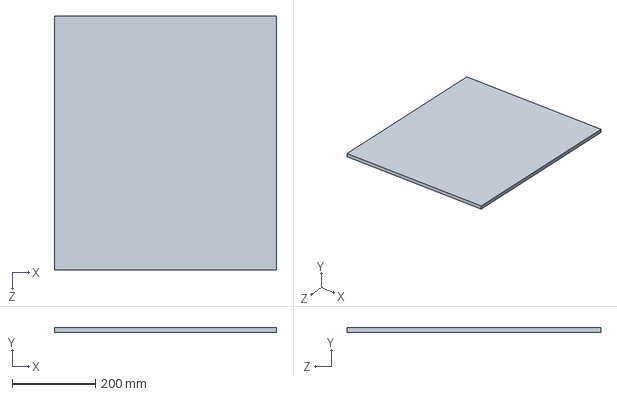
[picture p55: CAD file, 2018-09-25]
CAD/assem_controls.SLDASM
533.4 x 11.5 x 609.6 mm
