skurwa/smart-cart/CAD/Manufacturing/STL/ultrasonicSensorLeftMount.STL

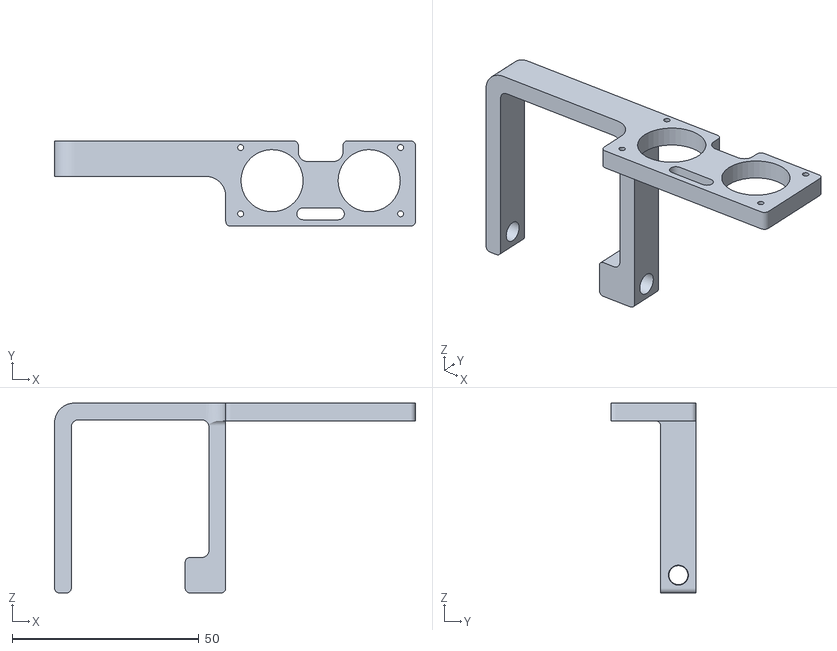
[picture p56: CAD file, 2018-11-11]
CAD/Manufacturing/STL/ultrasonicSensorLeftMount.STL
96.6 x 22.9 x 50.8
