skurwa/smart-cart/CAD/column.SLDPRT

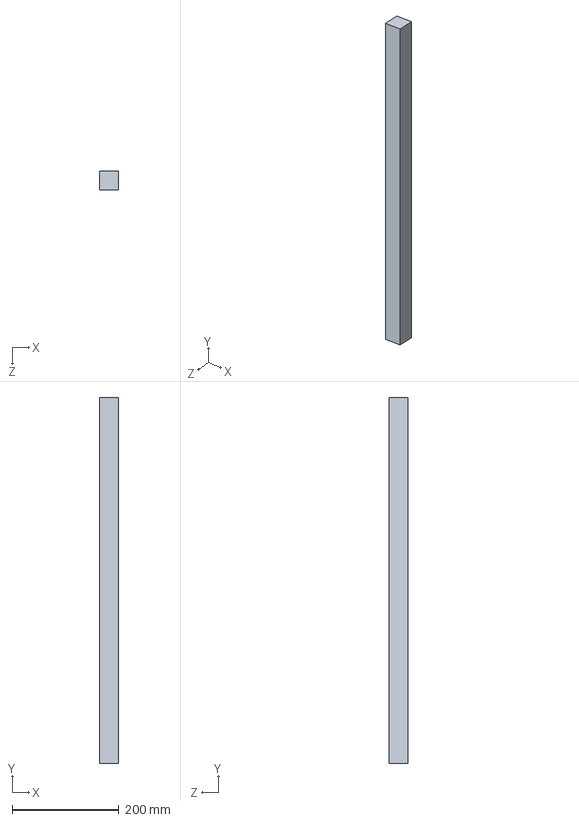
[picture p57: CAD file, 2018-11-27]
CAD/column.SLDPRT
34.8 x 685.8 x 34.9 mm
