skurwa/smart-cart/CAD/Purchased Parts/wheel.SLDPRT

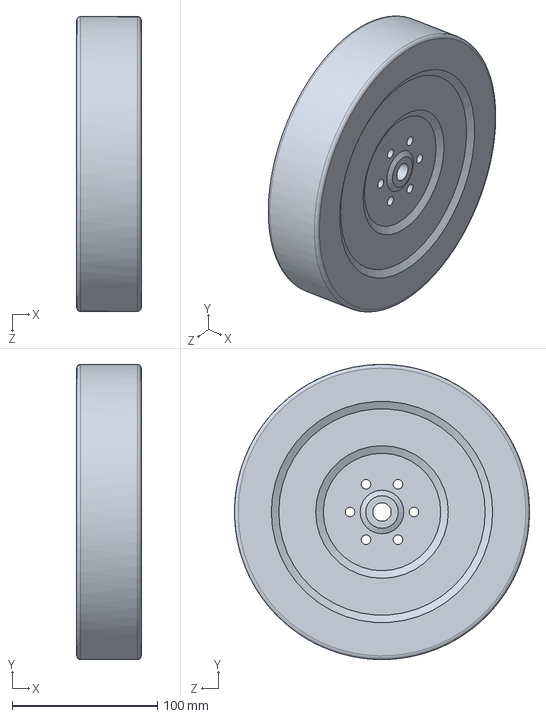
[picture p58: CAD file, 2018-11-11]
CAD/Purchased Parts/wheel.SLDPRT
44.5 x 203.2 x 203.2 mm
