skurwa/smart-cart/CAD/basketSiding.SLDPRT

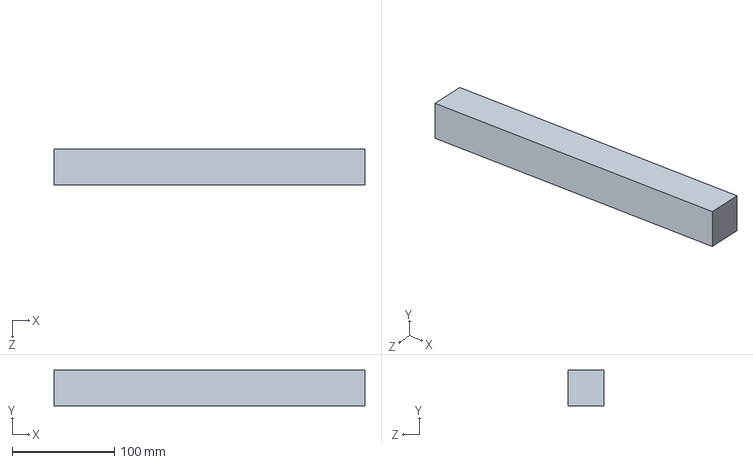
[picture p59: CAD file, 2018-11-27]
CAD/basketSiding.SLDPRT
304.8 x 34.9 x 34.8 mm
