skurwa/smart-cart/CAD/Manufacturing/STL/ultrasonicSensorCenterMount.STL

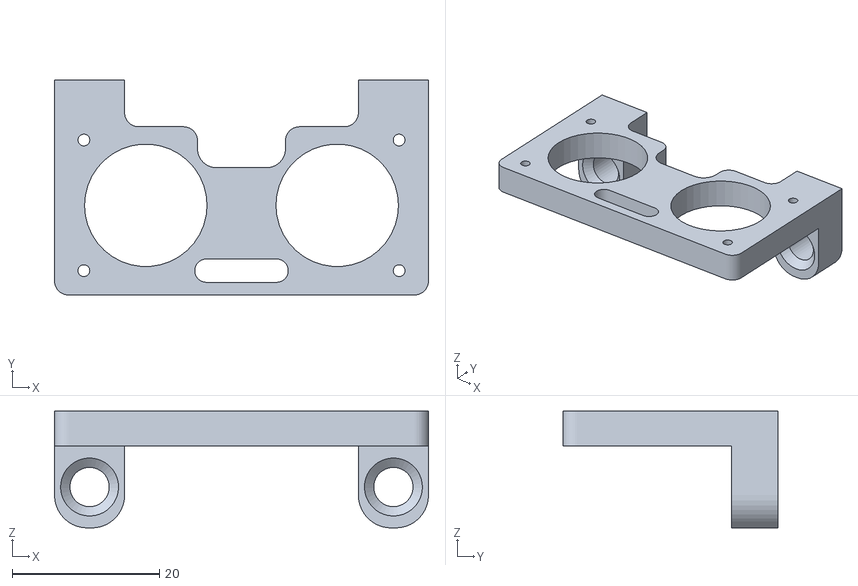
[picture p60: CAD file, 2018-11-11]
CAD/Manufacturing/STL/ultrasonicSensorCenterMount.STL
50.8 x 29.2 x 15.9
