skurwa/smart-cart/CAD/Manufacturing/STL/arduinoNanoMount.STL

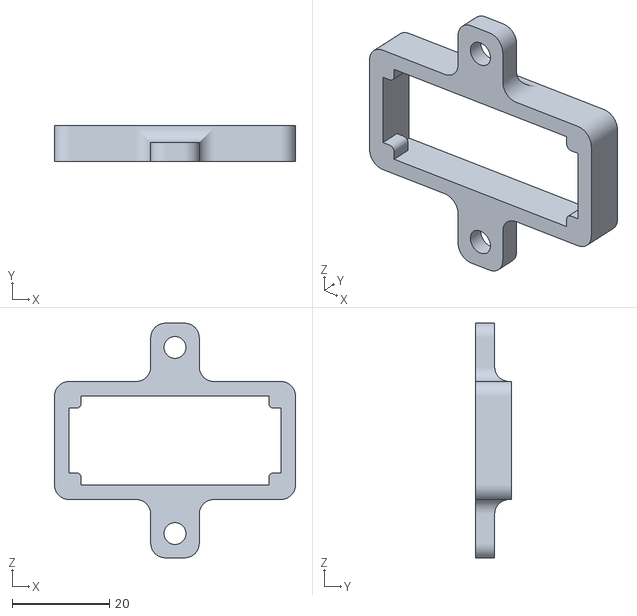
[picture p61: CAD file, 2018-11-11]
CAD/Manufacturing/STL/arduinoNanoMount.STL
49.6 x 7.50 x 48.3
