skurwa/smart-cart/CAD/Manufacturing/STL/compassMount.STL

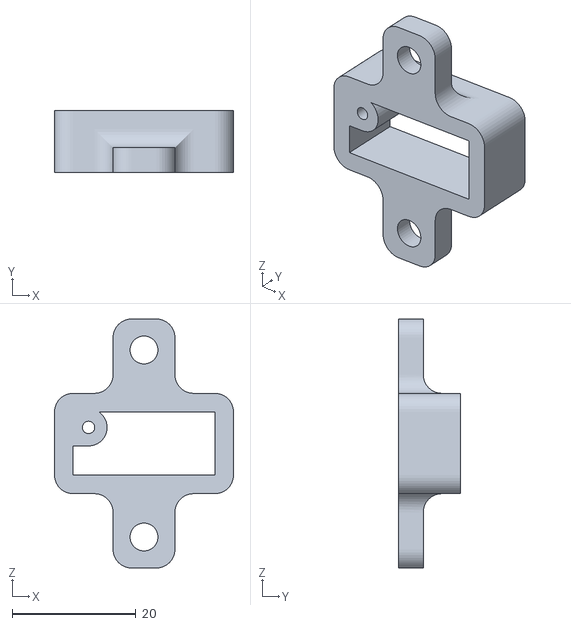
[picture p62: CAD file, 2018-11-08]
CAD/Manufacturing/STL/compassMount.STL
28.9 x 10.0 x 40.2
