skurwa/smart-cart/CAD/Purchased Parts/arduinoMega_Elegoo.SLDPRT

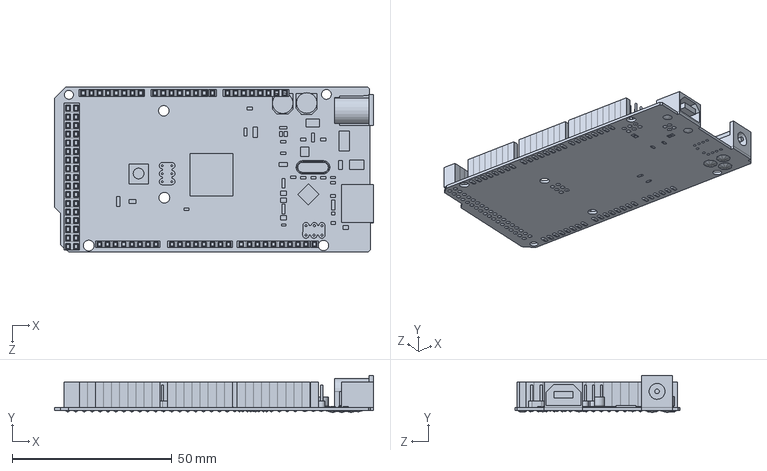
[picture p63: CAD file, 2018-11-08]
CAD/Purchased Parts/arduinoMega_Elegoo.SLDPRT
100.0 x 11.6 x 51.6 mm
