skurwa/smart-cart/CAD/Manufacturing/STL/motorDriverMount.STL

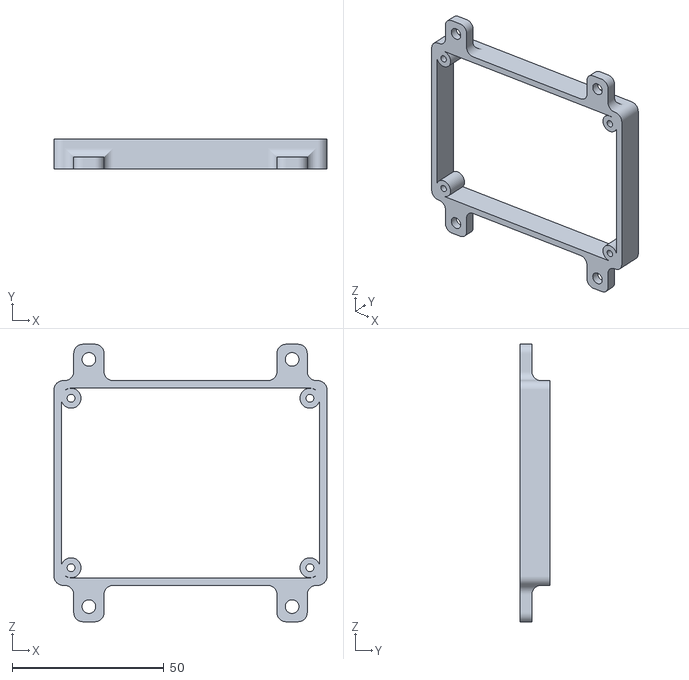
[picture p64: CAD file, 2018-11-08]
CAD/Manufacturing/STL/motorDriverMount.STL
90.0 x 10.0 x 91.5
