skurwa/smart-cart/CAD/Purchased Parts/compassIC_LSM303D.SLDPRT

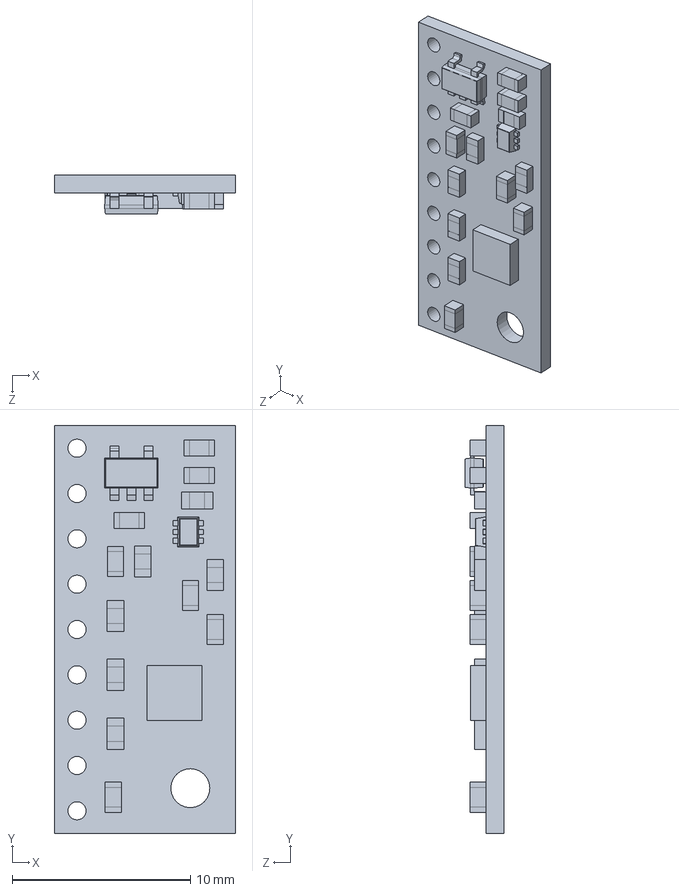
[picture p65: CAD file, 2018-11-08]
CAD/Purchased Parts/compassIC_LSM303D.SLDPRT
10.2 x 22.9 x 2.21 mm
