skurwa/smart-cart/CAD/lowerBasketPlatform.SLDPRT

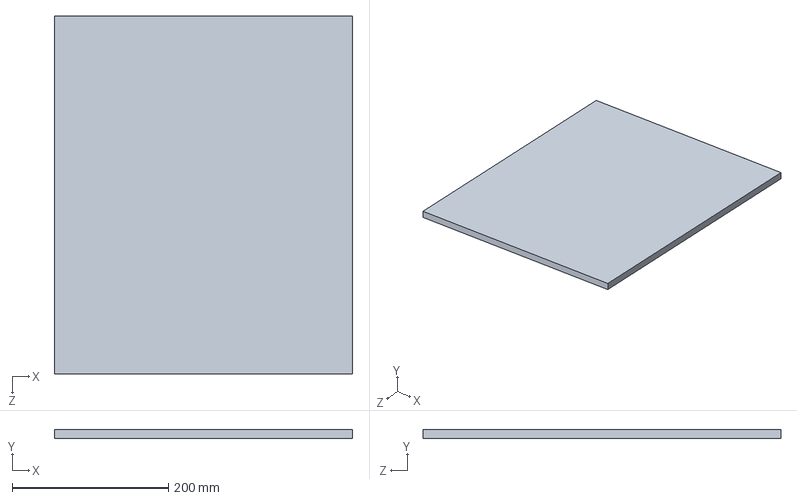
[picture p66: CAD file, 2018-11-11]
CAD/lowerBasketPlatform.SLDPRT
381.0 x 11.5 x 457.2 mm
