skurwa/smart-cart/CAD/Manufacturing/STL/hub.STL

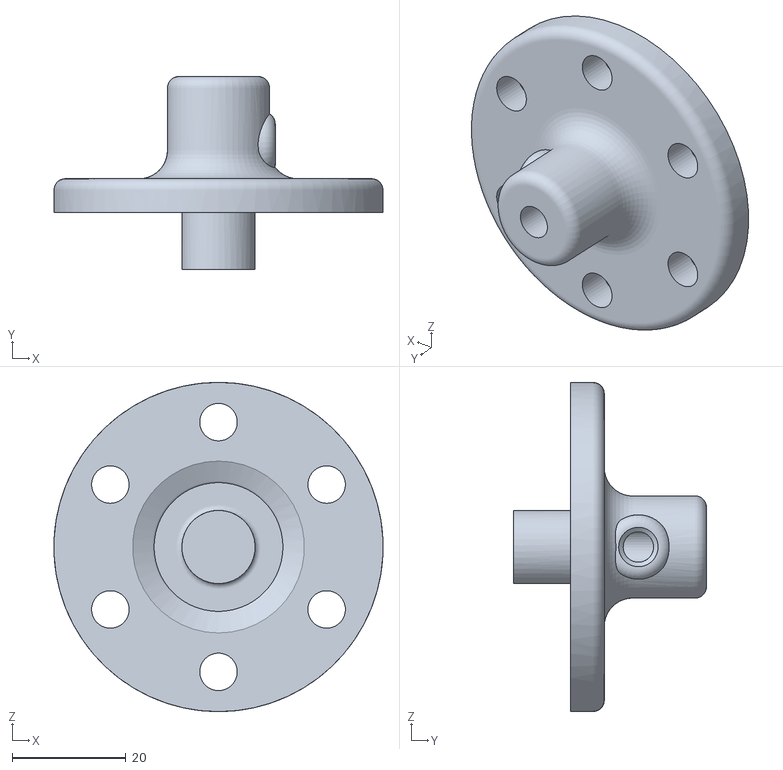
[picture p67: CAD file, 2018-10-30]
CAD/Manufacturing/STL/hub.STL
58.0 x 34.0 x 58.0
