skurwa/smart-cart/CAD/Purchased Parts/slaBattery_ExpertPower.SLDPRT

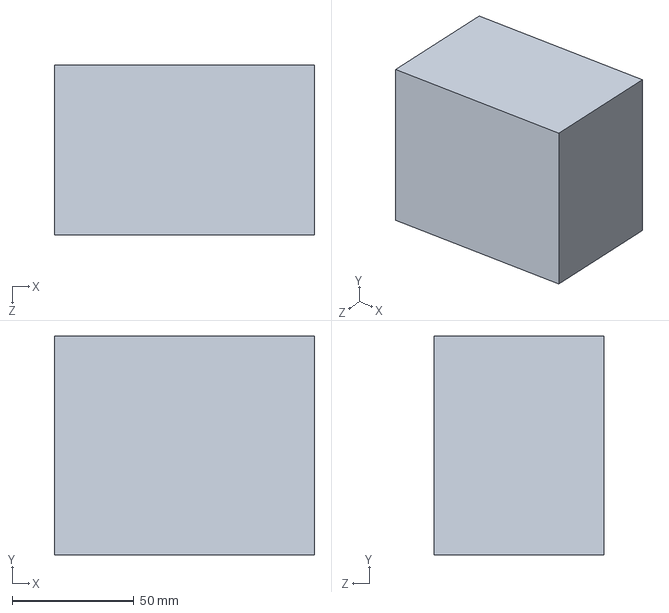
[picture p68: CAD file, 2018-11-08]
CAD/Purchased Parts/slaBattery_ExpertPower.SLDPRT
106.9 x 89.9 x 70.1 mm
