skurwa/smart-cart/CAD/Manufacturing/STL/frameBracket.STL

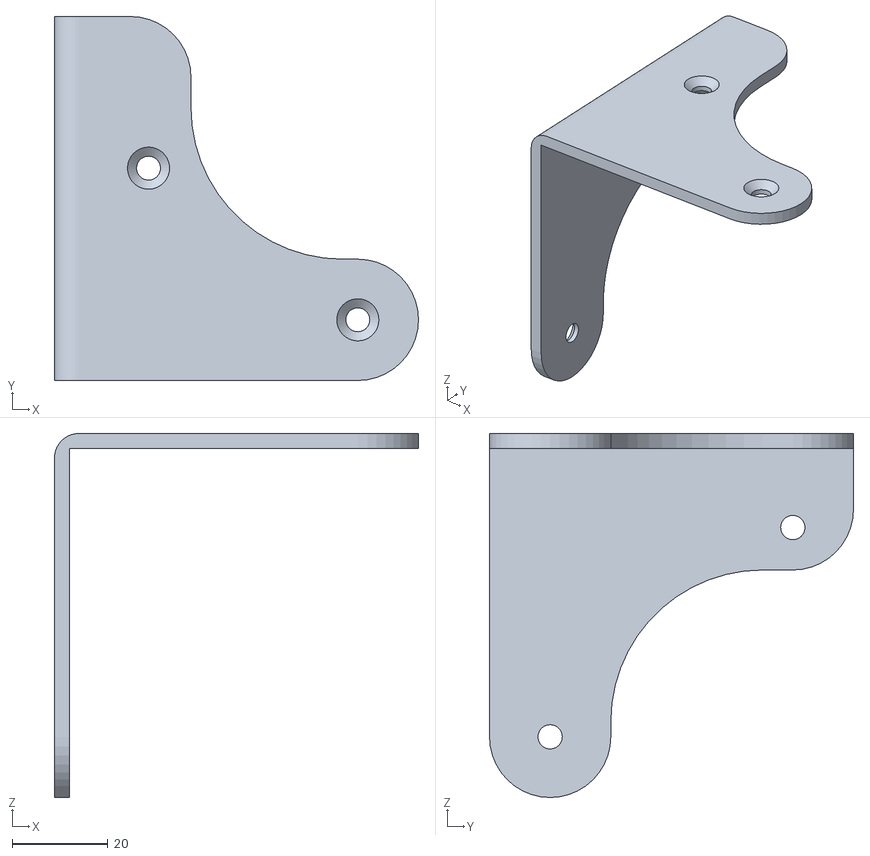
[picture p69: CAD file, 2018-09-25]
CAD/Manufacturing/STL/frameBracket.STL
76.2 x 76.2 x 76.2
