skurwa/smart-cart/CAD/Purchased Parts/servomotor_SG90.SLDPRT

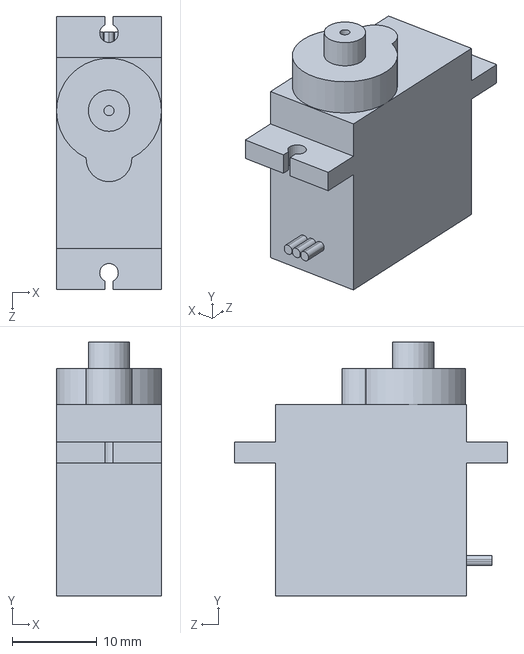
[picture p70: CAD file, 2018-09-25]
CAD/Purchased Parts/servomotor_SG90.SLDPRT
12.4 x 30.0 x 32.2 mm
