skurwa/smart-cart/CAD/casterMountingPlate.SLDPRT

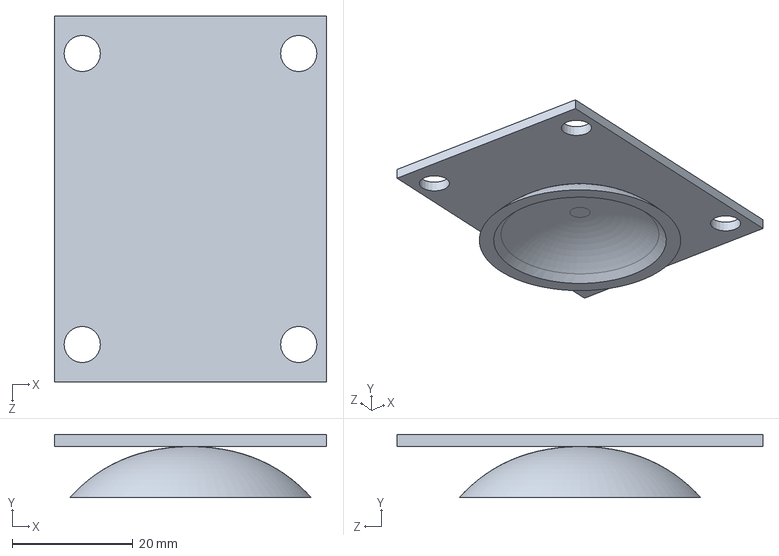
[picture p71: CAD file, 2018-11-11]
CAD/casterMountingPlate.SLDPRT
45.0 x 10.5 x 60.5 mm
