skurwa/smart-cart/CAD/Manufacturing/STL/controlsPlatformSupport.STL

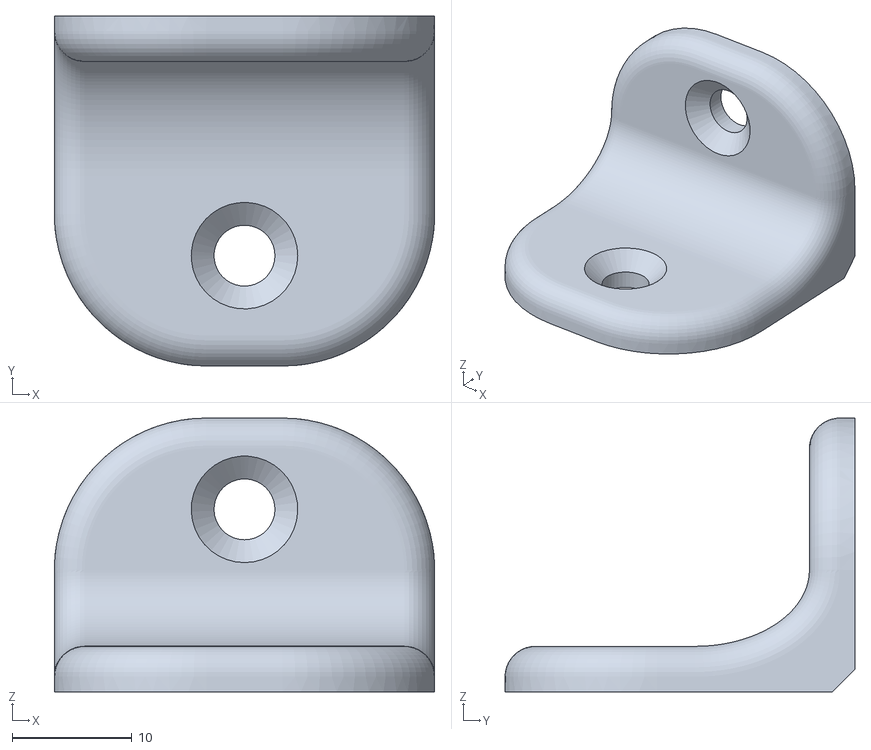
[picture p72: CAD file, 2018-09-25]
CAD/Manufacturing/STL/controlsPlatformSupport.STL
31.8 x 29.2 x 22.9
