skurwa/smart-cart/CAD/hub_v2.SLDPRT

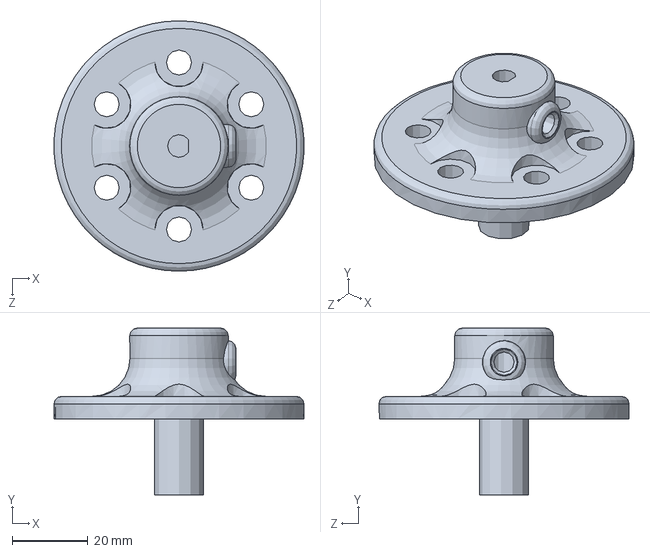
[picture p73: CAD file, 2018-11-11]
CAD/hub_v2.SLDPRT
65.9 x 44.0 x 66.0 mm
