skurwa/smart-cart/CAD/Manufacturing/STL/motorMount.STL

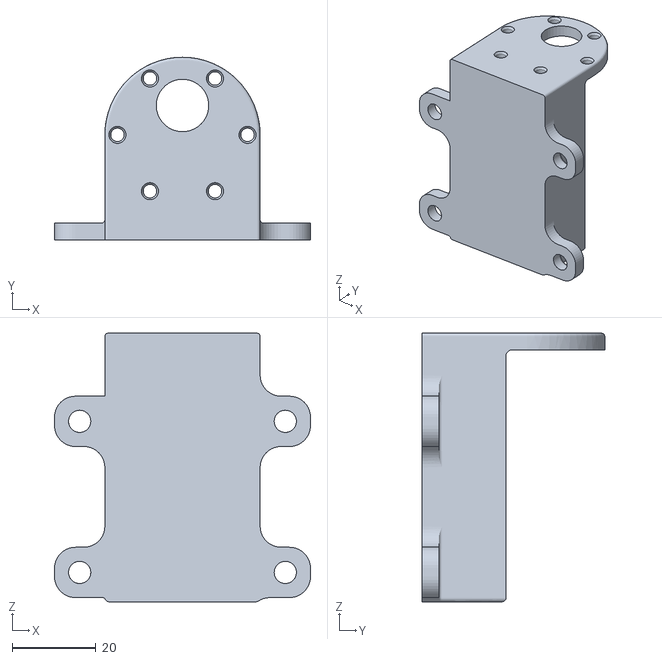
[picture p74: CAD file, 2018-09-20]
CAD/Manufacturing/STL/motorMount.STL
61.0 x 43.5 x 64.0
