skurwa/smart-cart/CAD/compassMount.SLDPRT

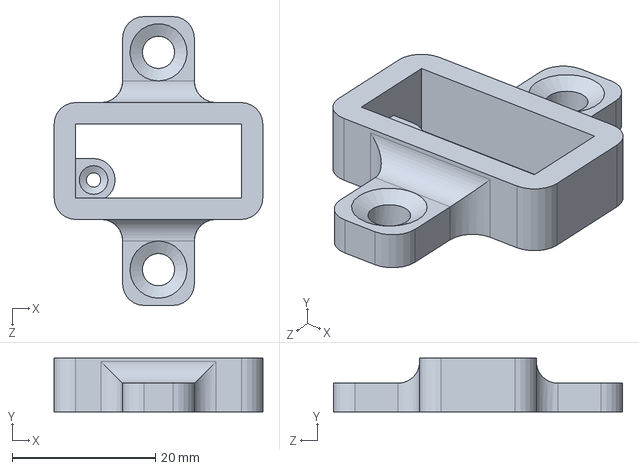
[picture p75: CAD file, 2018-11-11]
CAD/compassMount.SLDPRT
29.1 x 7.50 x 40.3 mm
