skurwa/smart-cart/CAD/casterWheel.SLDPRT

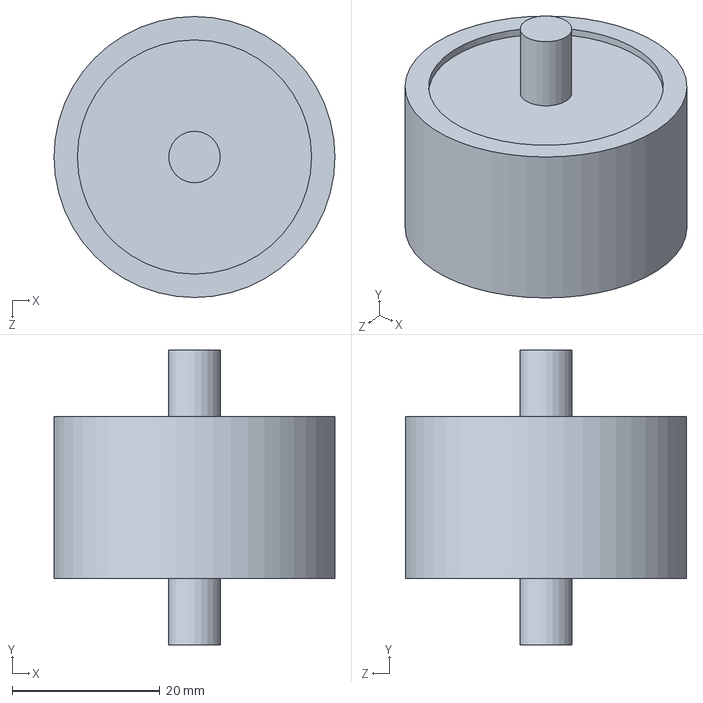
[picture p76: CAD file, 2018-11-11]
CAD/casterWheel.SLDPRT
38.1 x 40.0 x 38.1 mm
