skurwa/smart-cart/CAD/casterSwivel.SLDPRT

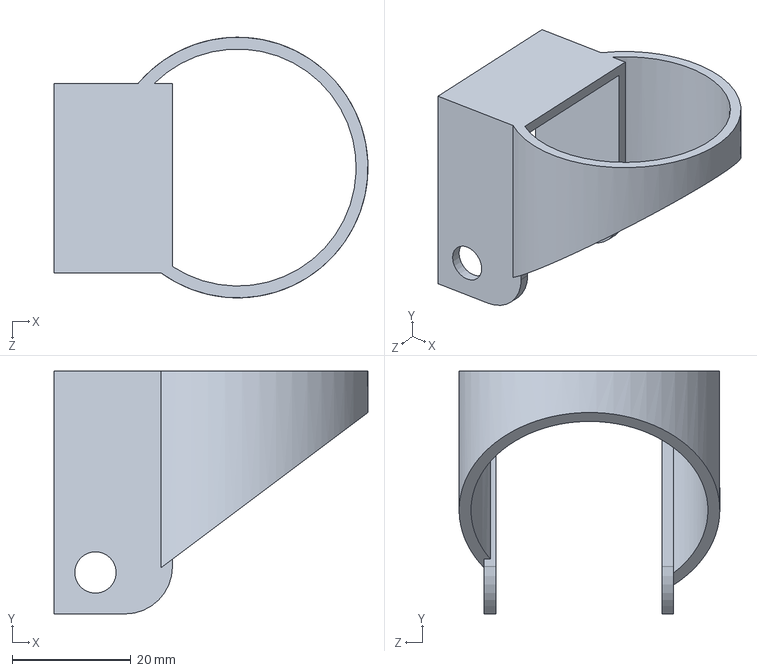
[picture p77: CAD file, 2018-11-11]
CAD/casterSwivel.SLDPRT
53.0 x 41.0 x 44.0 mm
