skurwa/smart-cart/CAD/basketPlatform.SLDPRT

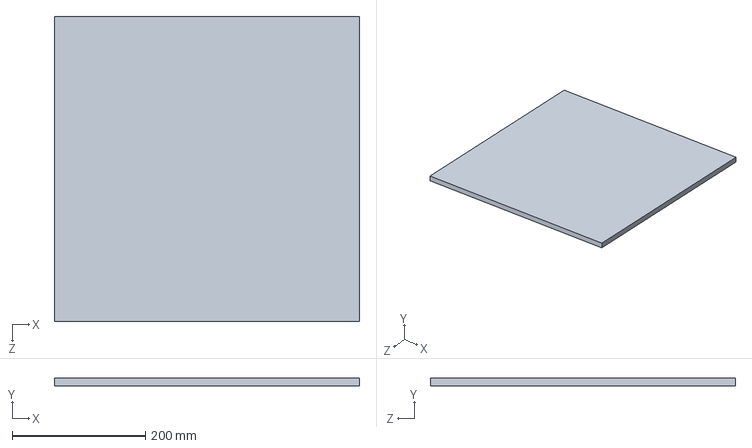
[picture p78: CAD file, 2018-11-08]
CAD/basketPlatform.SLDPRT
457.2 x 11.5 x 457.2 mm
