skurwa/smart-cart/CAD/side.SLDPRT

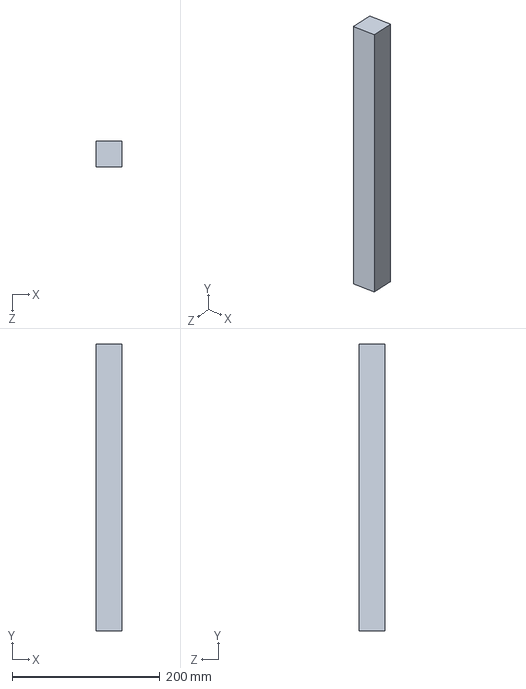
[picture p79: CAD file, 2018-11-08]
CAD/side.SLDPRT
34.8 x 388.6 x 34.9 mm
