skurwa/smart-cart/CAD/arduinoMegaMount.SLDPRT

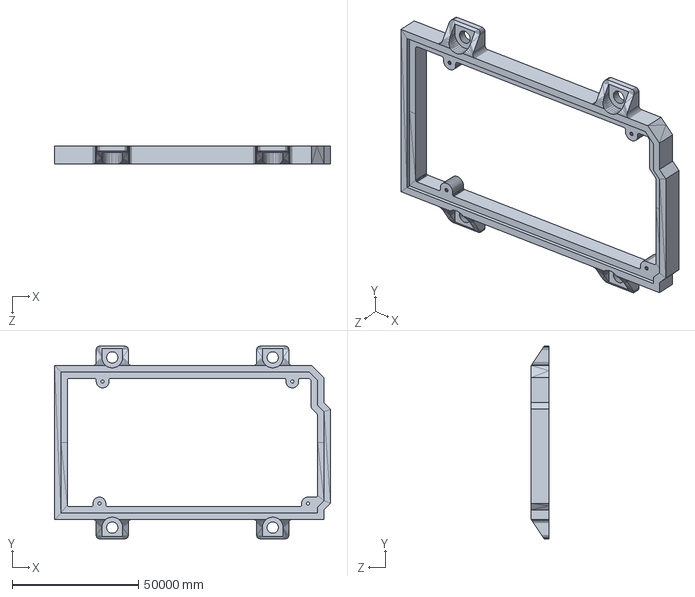
[picture p80: CAD file, 2018-11-08]
CAD/arduinoMegaMount.SLDPRT
109220.0 x 76200.0 x 6985.0 mm
