skurwa/smart-cart/CAD/ultrasonicSensorRightMount.SLDPRT

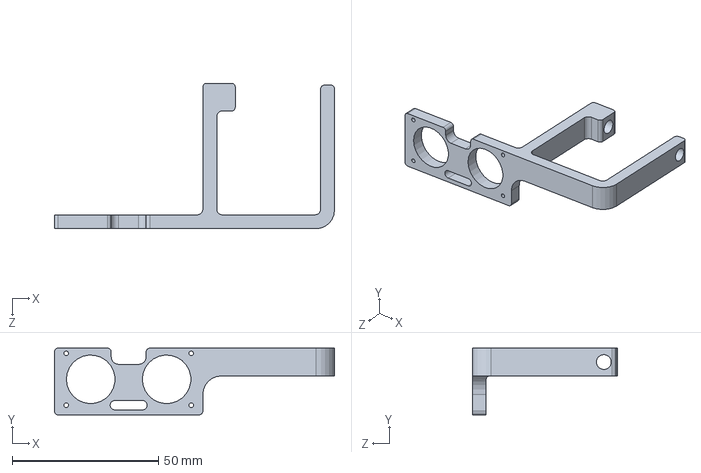
[picture p81: CAD file, 2018-11-08]
CAD/ultrasonicSensorRightMount.SLDPRT
95.9 x 22.9 x 49.8 mm
