skurwa/smart-cart/CAD/groundBlock.SLDPRT

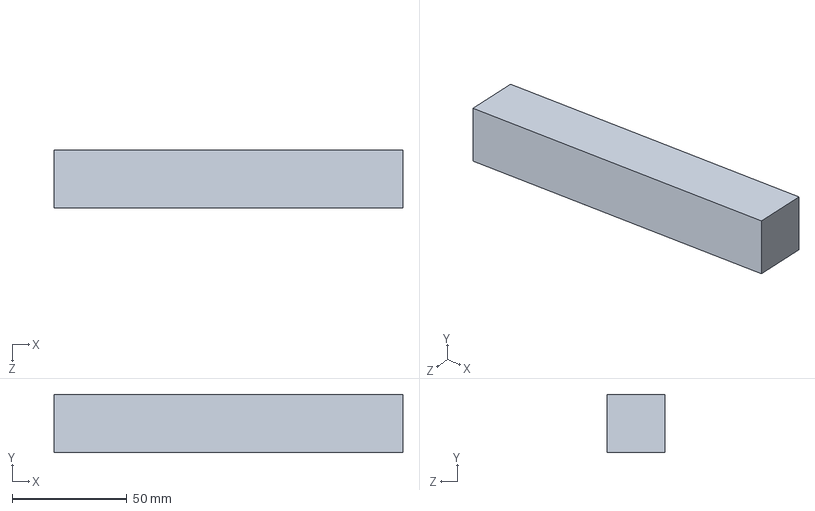
[picture p82: CAD file, 2018-11-08]
CAD/groundBlock.SLDPRT
152.4 x 25.4 x 25.4 mm
