skurwa/smart-cart/(list of files, cad)

Other CAD files:
CAD/assem_rightMountedUSSensor.SLDASM
CAD/Manufacturing/STL/ultrasonicSensorRightMount.STL
CAD/ultrasonicSensorLeftMount.SLDPRT
CAD/arduinoNanoMount.SLDPRT
CAD/lowerPlatformSupport.SLDPRT
CAD/frameBracket.SLDPRT
CAD/motorDriverMount.SLDPRT
CAD/drivePlatform.SLDPRT
CAD/ultrasonicSensorCenterMount.SLDPRT
CAD/motorMount.SLDPRT
CAD/Manufacturing/STL/hub_v2.STL
CAD/Purchased Parts/91772A197_18-8 SS PAN HEAD PHILLIPS MACHINE SCREW.SLDPRT
CAD/Purchased Parts/91772A205_18-8 SS PAN HEAD PHILLIPS MACHINE SCREW.SLDPRT
CAD/Purchased Parts/93365A142_HEAT-SET INSERTS FOR PLASTICS.SLDPRT
CAD/hub.SLDPRT
