skurwa/smart-cart/(commit log)

2018-09-03 Backing up initial project work
    [.25in Shaft.SLDPRT, 3mm Shaft.SLDPRT, 57655K110_PLASTIC GEAR--14-.5 DEG PRESSURE ANGLE.SLDPRT, 57655K310_PLASTIC GEAR--14-.5 DEG PRESSURE ANGLE.SLDPRT, 6mm-.25in Coupling.SLDPRT, 94180A331_HEAT-SET INSERTS FOR PLASTICS.SLDPRT, BOM.xlsx, Mechanical Analysis.xlsx]
2018-09-16 I2C master/slave comm; library skeletons
    [BOM.xlsx, Mechanical Analysis.xlsx]
2018-09-20 cart frame development
    [.25in Shaft.SLDPRT, 3mm Shaft.SLDPRT, 57655K110_PLASTIC GEAR--14-.5 DEG PRESSURE ANGLE.SLDPRT, 57655K310_PLASTIC GEAR--14-.5 DEG PRESSURE ANGLE.SLDPRT, 6mm-.25in Coupling.SLDPRT, 94180A331_HEAT-SET INSERTS FOR PLASTICS.SLDPRT, BOM.xlsx, Motor Mounting Bracket.SLDPRT]
2018-09-24 added i2c comm test code
2018-09-25 CAD updates and 3D prints, i2c floating point comm tested and functionality added to main
    [2012-CAP.sldprt, 2012.sldprt, 2510 PCB Connector Base_05.sldprt, 2510 PCB Pin.sldprt, CHEMICON-F.sldprt, CHEMICON-J.sldprt, DPAK.sldprt, L-5852-CYL.sldprt]
2018-09-26 completed encoder testing; added PID goal-state switches to master
2018-09-26 Tested and tuned PID controller over I2C comm
2018-09-28 controls components CAD
    [2012-CAP.sldprt, 2012.sldprt, 2510 PCB Connector Base_05.sldprt, 2510 PCB Pin.sldprt, CHEMICON-F.sldprt, CHEMICON-J.sldprt, DPAK.sldprt, L-5852-CYL.sldprt]
2018-10-04 Confirmed wheel analysis, added wheels to BOM
    [BOM.xlsx, Mechanical Analysis.xlsx]
2018-10-17 Added framework to develop ultrasonic sensor-based obstacle detection and avoidance
    [master_main.ino, slaveUltrasonic_main.ino]
2018-10-18 Updated hub design and modified platform sizes
    [assem_drive.SLDASM, assem_frame.SLDASM, assem_wheelDrive.SLDASM, basketPlatform.SLDPRT, controlsPlatform.SLDPRT, drivePlatform.SLDPRT, hub.SLDPRT, side.SLDPRT]
2018-10-30 Updated hub STL design
    [hub_v2.STL]
2018-10-30 updated hub design
    [hub_v2.SLDPRT]
2018-10-30 code updates
    [BOM.xlsx, Mechanical Analysis.xlsx, hub.STL]
2018-11-08 mounting and bracketing CAD
    [arduinoMegaMount.SLDPRT, arduinoMega_Elegoo.SLDPRT, arduinoNanoMount.SLDPRT, assem_drive.SLDASM, assem_frame.SLDASM, assem_leftMountedUSSensor.SLDASM, assem_rightMountedUSSensor.SLDASM, assem_wheelDrive.SLDASM]
2018-11-11 Finalized CAD; started final report
    [91772A197_18-8 SS PAN HEAD PHILLIPS MACHINE SCREW.SLDPRT, 91772A205_18-8 SS PAN HEAD PHILLIPS MACHINE SCREW.SLDPRT, 93365A142_HEAT-SET INSERTS FOR PLASTICS.SLDPRT, arduinoNanoMount.SLDPRT, assem_caster.SLDASM, assem_centerMountedUSSensor.SLDASM, assem_frame.SLDASM, assem_leftMountedUSSensor.SLDASM]
2018-11-11 Made print files; began final poster/report
    [arduinoNanoMount.STL, ultrasonicSensorCenterMount.STL, ultrasonicSensorLeftMount.SLDPRT, ultrasonicSensorLeftMount.STL, ultrasonicSensorRightMount.STL]
2018-11-12 poster prep
    [Mechanical Analysis.xlsx, assem_leftMountedUSSensor.SLDASM, ultrasonicSensorLeftMount.SLDPRT]
2018-11-12 poster draft
    [Mechanical Analysis.xlsx]
2018-11-15 Updated PID controller, improved i2C master request comm, pictures for poster
2018-11-27 updated final deliverables
    [BOM.xlsx]
2018-11-27 Finalized poster, updated cart basket design
    [assem_frame.SLDASM, assem_wheelDrive.SLDASM, basketSiding.SLDPRT, column.SLDPRT]
